fcpage/EngPrg3/Datasheets/Stepper Motor/Pololu - A4988 Module Setup_files/0J10063.1200.jpg

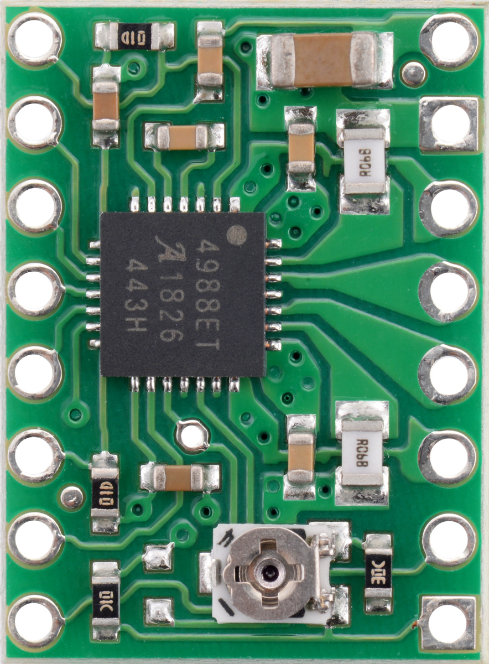
Datasheets/Stepper Motor/Pololu - A4988 Module Setup_files/0J10063.1200.jpg
