fcpage/EngPrg3/Datasheets/Stepper Motor/Pololu - A4988 Module Schematic_files/0J10062.1200.jpg

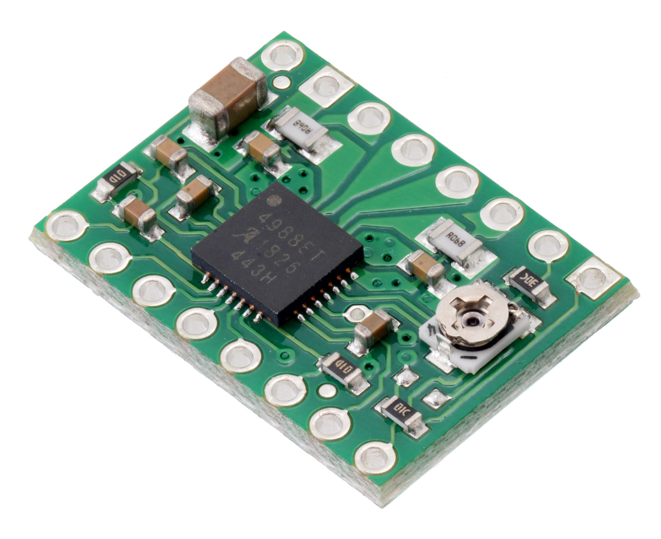
Datasheets/Stepper Motor/Pololu - A4988 Module Schematic_files/0J10062.1200.jpg
