fcpage/EngPrg3/Datasheets/RPI5/RPI Documentation Link.txt

https://www.raspberrypi.com/documentation/
