fcpage/EngPrg3/Presentation/ESE Engineering Project V.pptx

## ESE Engineering Project V Project 3: Etch Auto Sketch

Fergus Page
December 4th, 2025

## Project Overview:

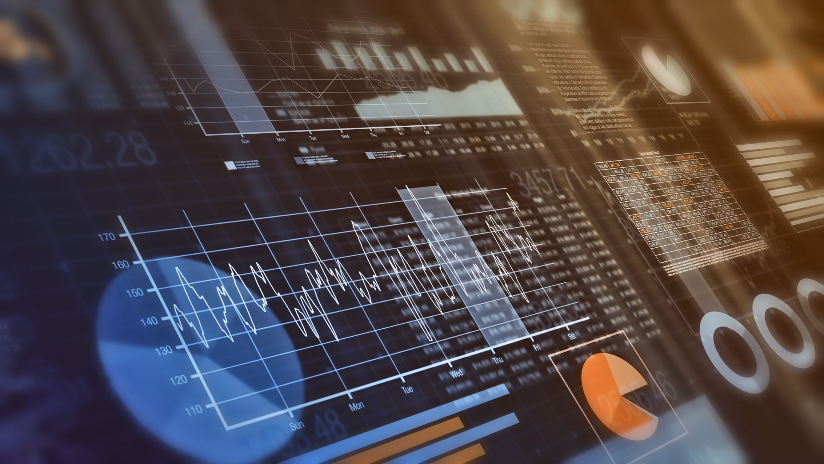
[picture p3: figure]
Digital financial graph

Posture-recognition software evaluates user.
Posture encoded as controller commands.
Software communicates wirelessly with controller.
Controller articulates Etch A Sketch.
PI-Controlled DC, stepper motors.

## Extended Applications

Remote, multi-pilot medical robots.
Exactly-repeated experimental research iterations.
Proxy agent for dangerous work.
A whimsical home message board.
User-scaling APPLICATIONS & COMBINATIONAL CONTROL.

## United Nations Sustainable Development Goals

Goal 3: Good Health and Wellbeing.
Goal 4: Quality Education.
Goal 9: Industry, Innovation, and Infrastructure.
Goal 10: Reduced Inequalities.
Goal 17: Partnerships for the Goals.

## System Overview

RPi 5 and STM32F303RE
Webcam, NRF24L01+, SSD1306, TL082, TL084
L293D and A4899
FIT0185 and 17HS4401S
Etch A Sketch – Large, Red

## Software and Control Considerations

Raspbian Linux video capture/DSP.
RPi 5 and controller communicate bidirectionally.
C-coded finite state machine.
PI-controlled DC motor.
Controller features tunable physical alignment.

## RF, Safety, and Compliance Considerations

RF-Compliant Transceiver Module (EU)
IEC 62368-1 Compliant Power Supply (+)
Additional Copper Ground Buss (Supply)
Cable Routing by Signal Speed
Cable Routing by Power

## Top Level System Diagram

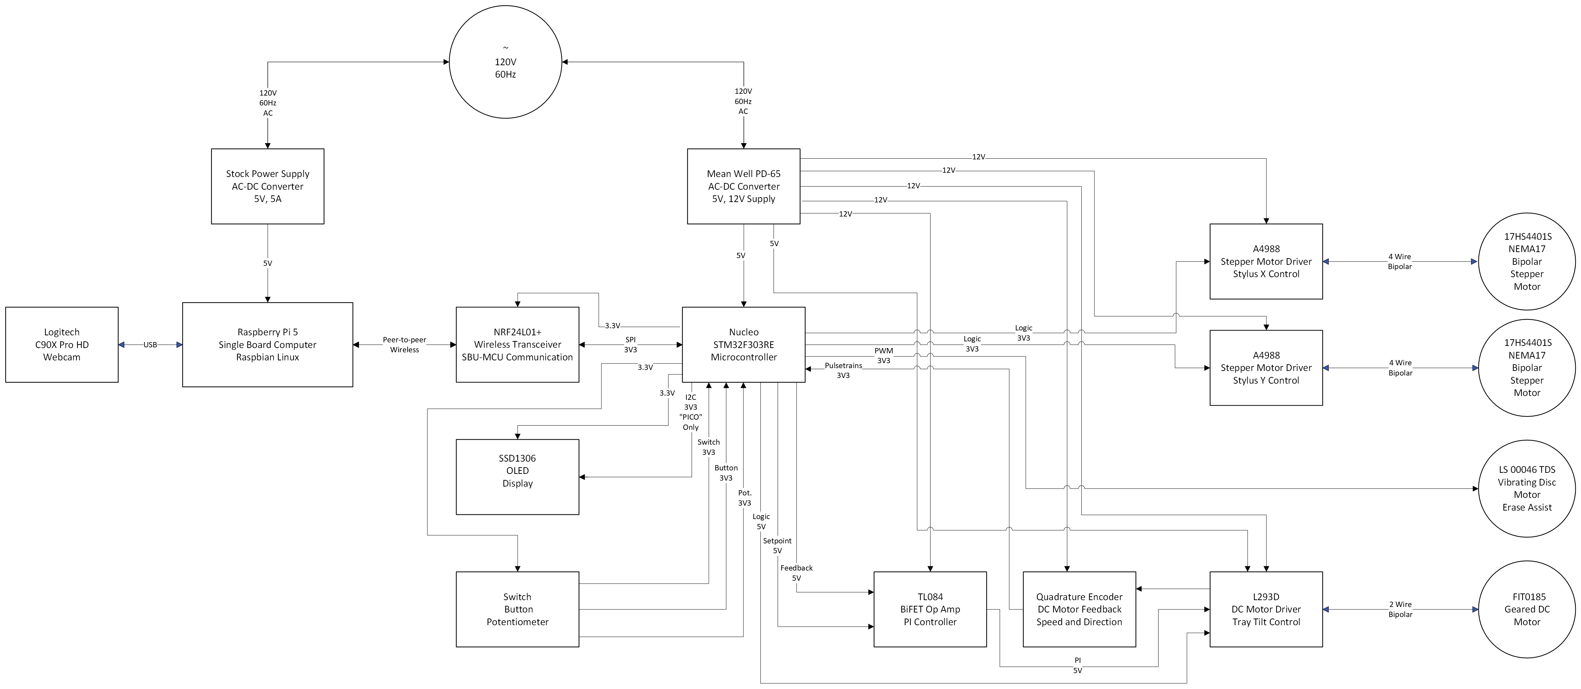
[picture p4: figure]

## System Prototype

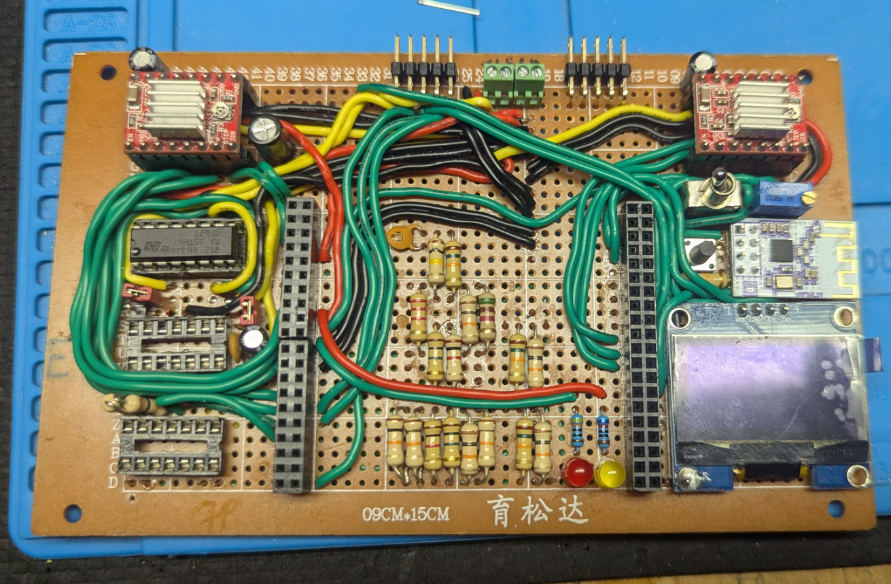
[picture p5: figure]
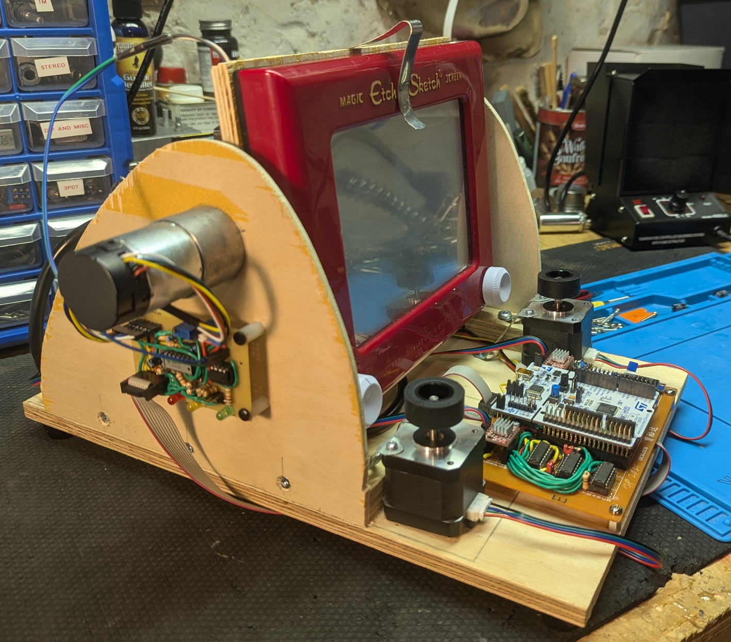
[picture p6: figure]
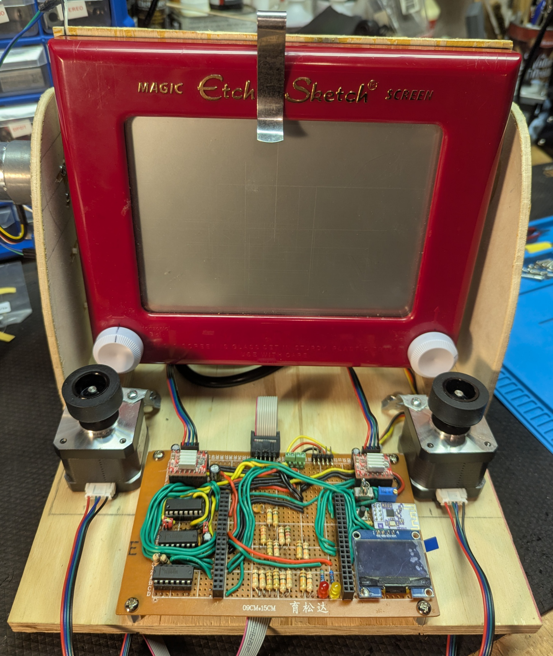
[picture p7: figure]
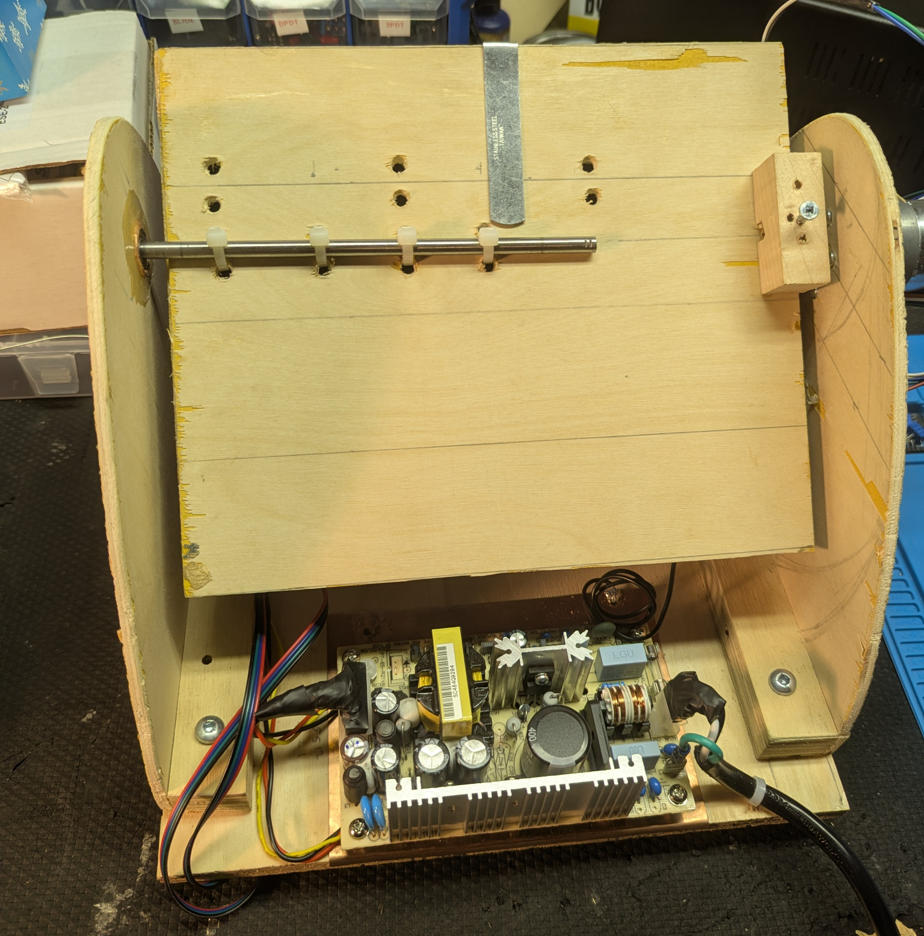
[picture p8: figure]

## DC Motor Characterization

FIT0185 High-Torque Geared Motor
Moment of Inertia Not Available
Calculated Approximate Value Using Datasheet
Motor Torque Exceeds Meter Limit

## Motor Characterization Calculations

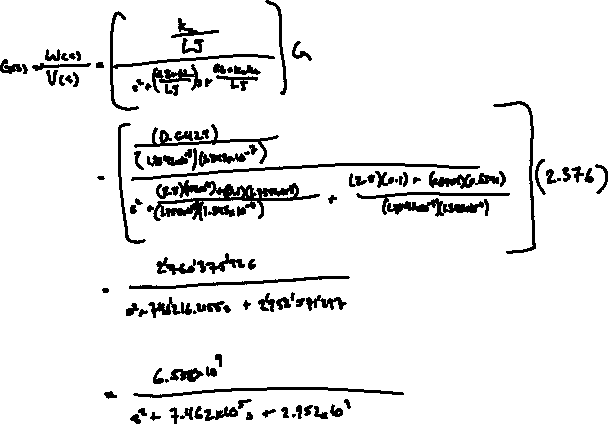
[picture p9: figure]
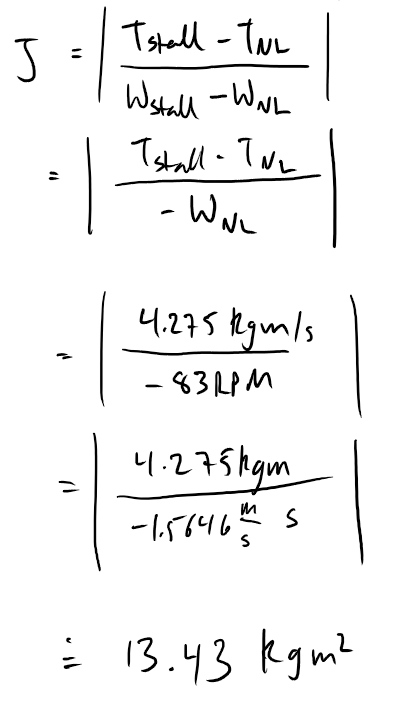
[picture p10: figure]
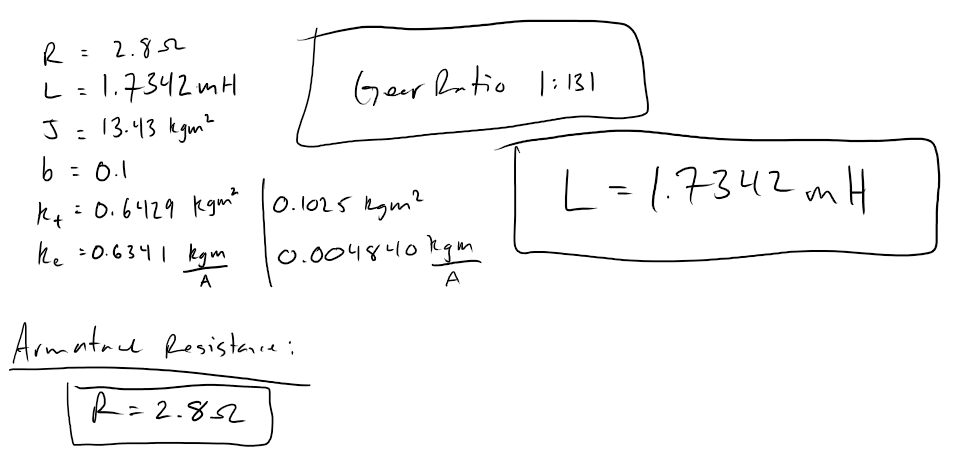
[picture p11: figure]
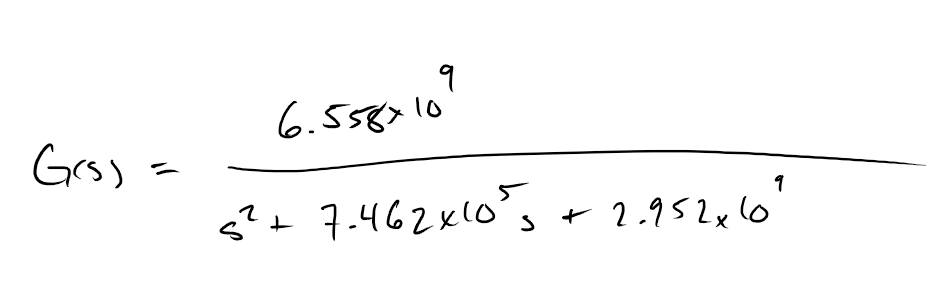
[picture p12: figure]

## Step Responses

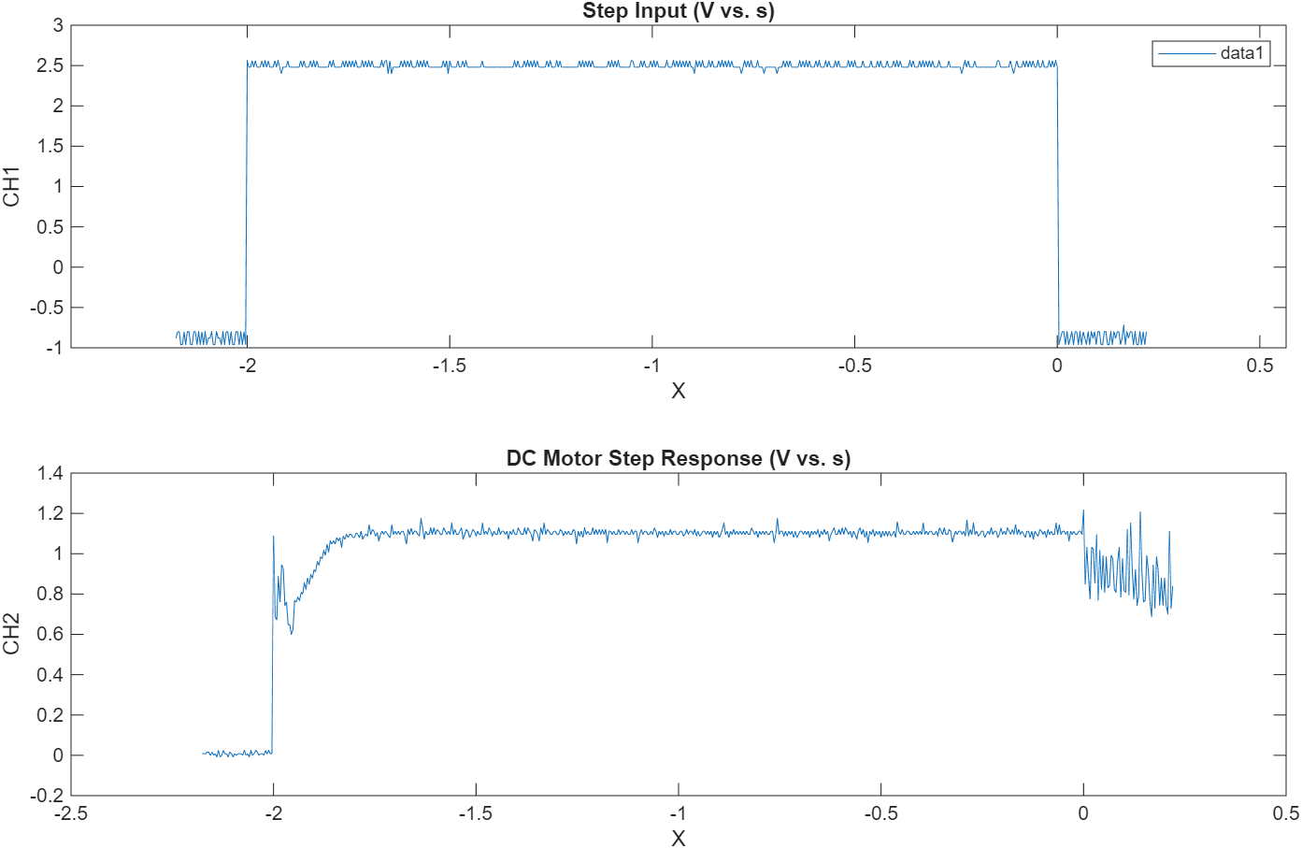
[picture p13: figure]
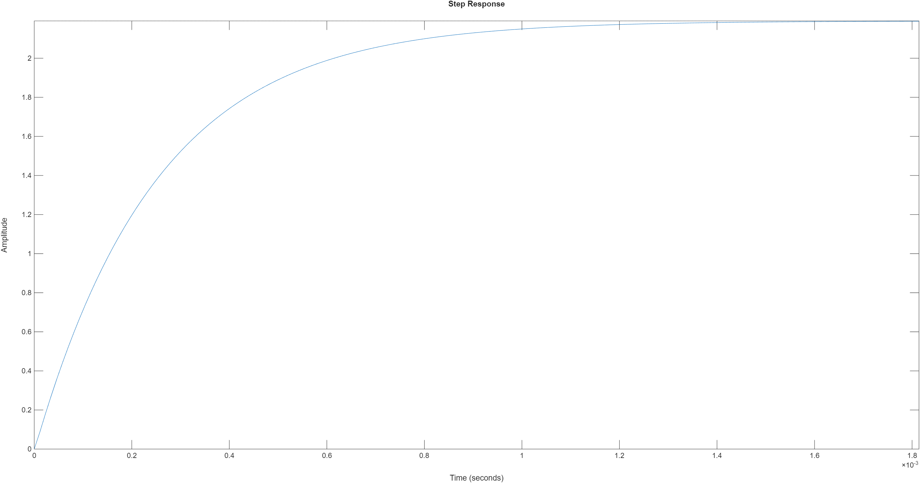
[picture p14: figure]

## PI Controller Calculations

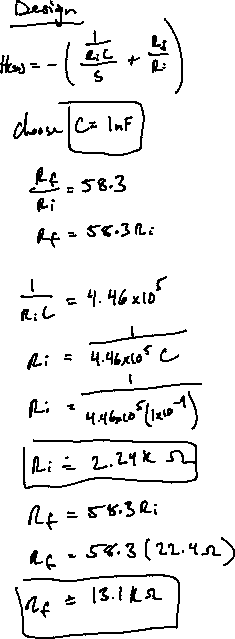
[picture p15: figure]
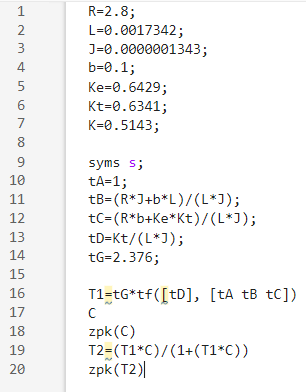
[picture p16: figure]
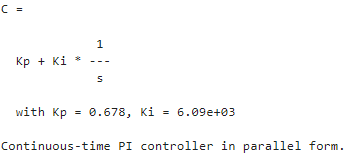
[picture p17: figure]
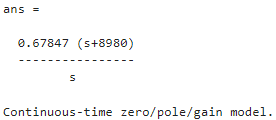
[picture p18: figure]

## PI Controller

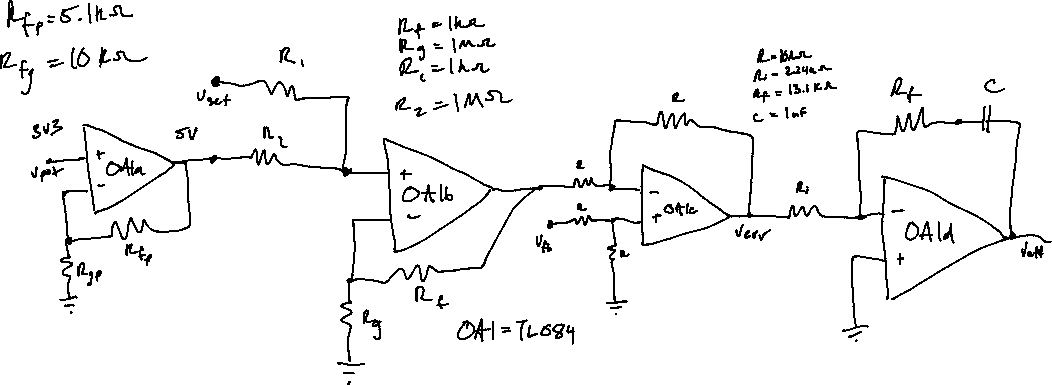
[picture p19: figure]

## DC Motor - Erase

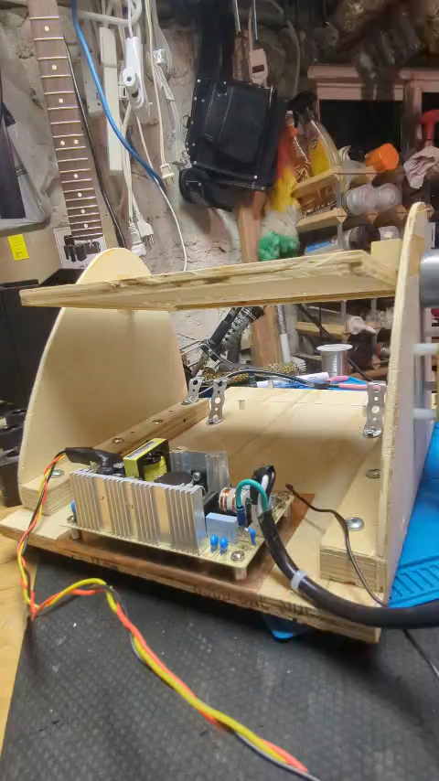
[picture p20: figure]

## Code Highlights

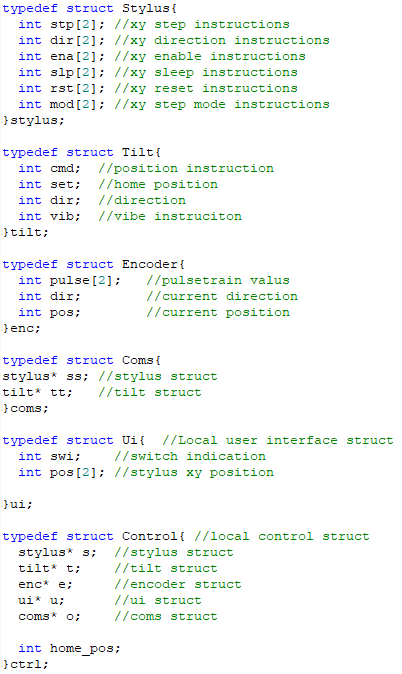
[picture p21: figure]
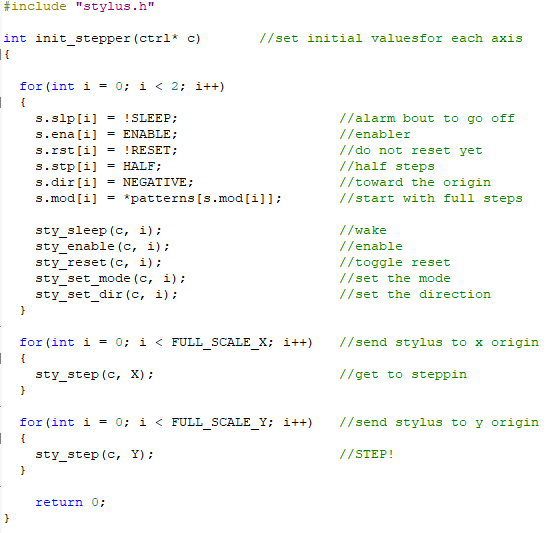
[picture p22: figure]

## Techniques, Resources, and Tools

Torque, Torsion, Tolerance, and Alignment
STM32, RPI5, Signal Generator, Oscilloscope
Quadrature Encoder, STM Encoder Mode
MATLAB PI Design, Electronic Implementation
MATLAB Oscilloscope Plotter Script

## Materials, Components, Sustainability & Circularity Design

Scrap Plywood: an Engineered Material
Low-Friction Bearing Reduces Load
Soft Rubber Rollers Grip Controls
Enables Aggressive Conservancy Measures, Safely
Remote-Physical Connection Reduces Waste

## Health, Social, Environmental Proactive Views

- Improves Rural & Remote Medical Access
- Protects Humans Doing Dangerous Work
- Enhances and Modernizes Scientific Research
- Enables New Controls and Applications
- Connects People and Humanoids Everywhere

## Acknowledgements

- Thank you to So-Ra Chung and Alireza Dehghani-Sanij for their help and guidance throughout this term, and with this project.
- I am very grateful, and I feel lucky to learn from them.

## References

Application Report: Designing Gain and Offset in Thirty Seconds, vol. SLOA097. Dallas: Texas Instruments, 2002.
