fcpage/EngPrg3/Datasheets/Stepper Motor/Pololu - A4988 Module Schematic_files/0J3359.600x480.jpg

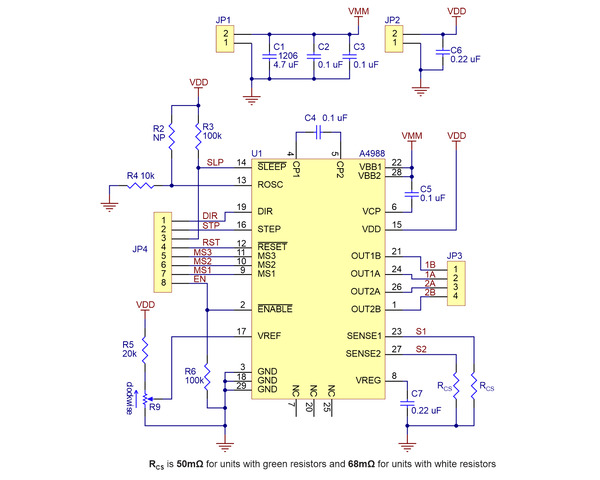
Datasheets/Stepper Motor/Pololu - A4988 Module Schematic_files/0J3359.600x480.jpg
