fcpage/EngPrg3/Photos/DCM Simulated/Motor Sim.png

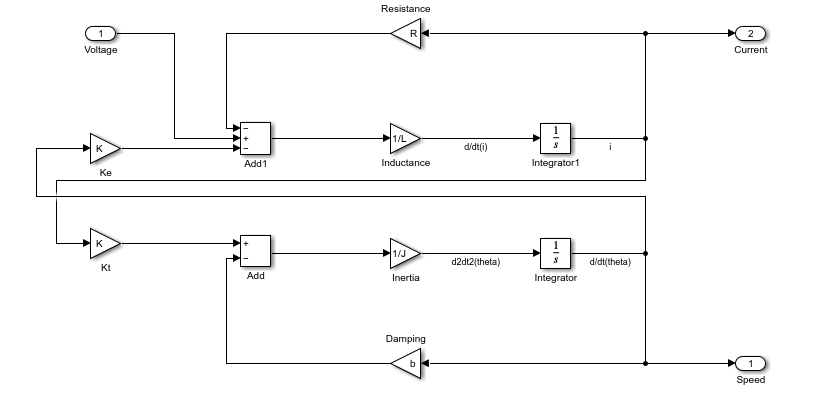
Photos/DCM Simulated/Motor Sim.png
