fcpage/EngPrg3/Photos/DCM Simulated/TRANSFER FUNCTION.png

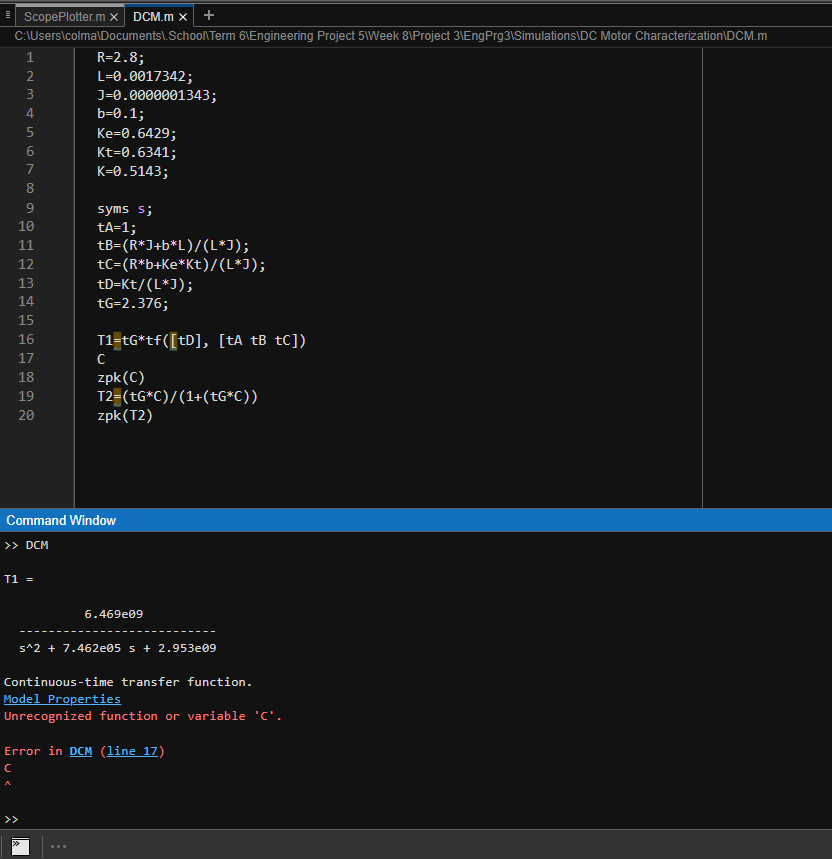
Photos/DCM Simulated/TRANSFER FUNCTION.png
