fcpage/EngPrg3/Photos/DCM Simulated/TUNED PI CONTROLLER.png

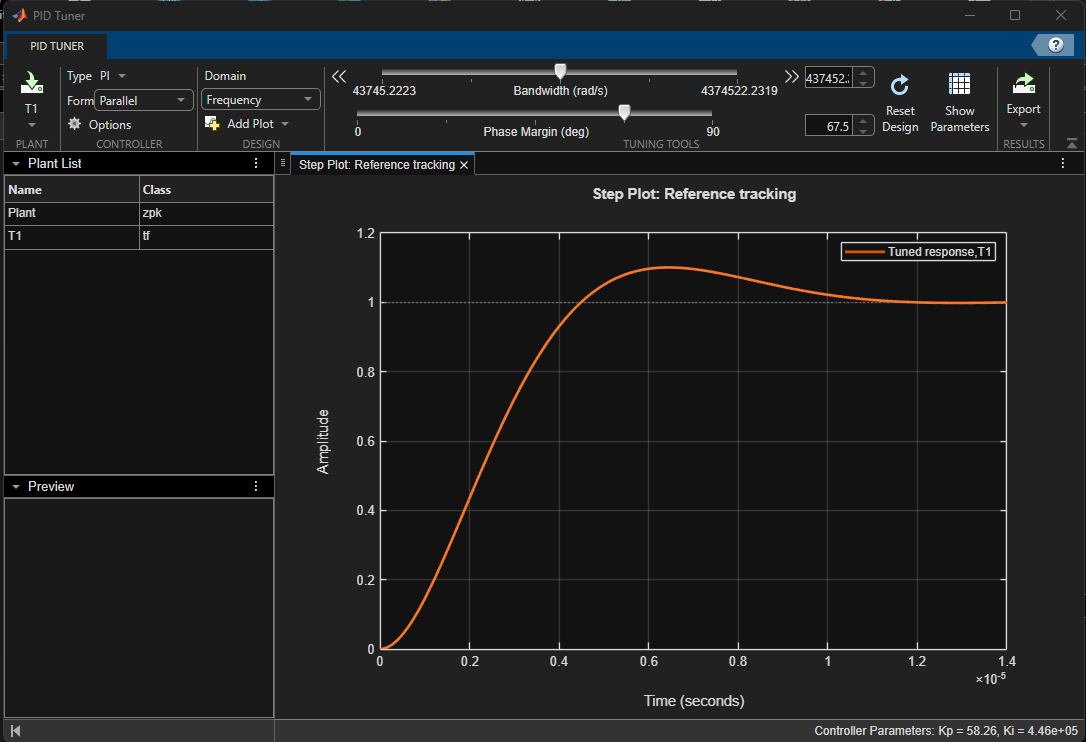
Photos/DCM Simulated/TUNED PI CONTROLLER.png
