fcpage/EngPrg3/Plans/Master Sheet.xlsx

Sheet: BOM
Description | Model | Manufacturer | Purchase Quantity | Project Quantity | Purchase Price | Price Each | Project Price | Total Price | Total Price Minus Brains
Linux SBC | RPI 5 | Raspberry Pi | 1 | 1 | $282.38 | $282.38 | $282.38 | $402.86 | $103.03
ARM Microcontroller | STM32F303RE | ST Microelectronics | 1 | 1 | $17.45 | $17.45 | $17.45
Quad Op Amp | TL084 | Texas Instruments | 1 | 1 | $3.33 | $3.33 | $3.33
Stepper Motor Driver | A4988 | Pololu/Allegro | 10 | 2 | $24.74 | $2.47 | $4.95
Stepper Motor | 17HS4401S | Handson Technology | 2 | 2 | $20.33 | $10.16 | $20.33
DC Motor Driver | L293D | Texas Instruments | 1 | 1 | $10.11 | $10.11 | $10.11
DC Motor | FIT0185 | DF Robot | 1 | 1 | $26.08 | $26.08 | $26.08
Vibrating Disc Motor | LS00046 | OSEPP | 2 | 1 | $8.98 | $4.49 | $4.49
LDO DC Regulator | LM2941C | Texas Instruments | 1 | 1 | $6.72 | $6.72 | $6.72
AC-DC Converter | PD-65A | Mean Well | 1 | 1 | $27.02 | $27.02 | $27.02

Sheet: Power Budget
Supply |  |  |  | Balance |  | Draw
Device |  |  |  | 5V Power Available | 12V Powet Available | Device | Rated Voltage (V) | Max Voltage (V) | Min Voltage (V) | Logic Voltage (V) | Motor Supply Voltage (V) | Chip Supply Voltage (V) | Logic Current (A) | Motor Current (A) | Target Current (A) | Rated Current (A) | Max Current (A) | Min Current (A) | Rated Power (W) | Max Power (W) | Min Power (W) | Extended Power Cost (W) | Total Power (W) | 5V Power | 12V Power
Mean Well PD-65A |  |  |  | 27.5 | 33.6 | RPI 5 | 5 | 5 | 5 | 3.3 | 0 | 0 |  | 0 | 0 | 5 | 5 | 5 | 25 | 25 | 25 | 25 | 46.5485 | 27.773 | 18.708
Parameter | Output A | Output B | Total | 5V Power Draw | 12V Power Draw | STM32 (E5V) | 5 | 5.25 | 4.75 | 3.3 | 0 | 3.6 |  | 0 | 0 | 0.5 | 0.5 | 0.1 | 2.5 | 2.625 | 0.475 | 2.5
Rated Voltage (V) | 5 | 12 |  | 27.773 | 18.708 | TL084 | 12 | 30 | 10 | 3.3 | 0 | 0 | 0.004 | 0 | 0.004 | 0.044 | 0.044 | 0.004 | 0.528 | 1.32 | 0.04 | 0.528
Rated Current (A) | 5.5 | 2.8 | 8.3 | 5V Power Balance | 12V Powet Balance | A4988 | 5 | 5.5 | 0.3 | 5 | 12 | 5 | 0.008 | 0 | 0.006 | 0.008 | 0.008 | 0.004 | 0.072 | 0.044 | 0.0012 | 0.088
Max Current (A) | 7 | 3.2 | 10.2 | -0.273 | 14.892 | 17HS4401S | 12 | 12 | 0 | 0 | 12 | 0 | 0 | 0.5 | 0.5 | 1.5 | 1.7 | 0.002 | 6 | 20.4 | 0 | 12
Min Current (A) | 0.4 | 0.2 | 0.6 | 5V Current Available | 12V Current Available | L293D | 7 | 7 | 4.5 | 5 | 0 | 5 | 0.041 | 0 | 0.041 | 0.037 | 0.066 | 0.021 | 0.185 | 0.462 | 0.0945 | 0.185
Rated Power (W) | 27.5 | 33.6 | 61.1 | 5.5 | 2.8 | FIT0185 | 12 | 12 | 0 | 0 | 12 | 0 | 0 | 0.5 | 0.5 | 0.5 | 7 | 0 | 6 | 84 | 0 | 6
Max Power (W) | 35 | 38.4 | 73.4 | 5V Current Draw | 12V Current Draw | LS00046 | 3.3 | 4.2 | 2.3 | 3.3 | 0 | 0 | 0 | 0 | 0.075 | 0.075 | 0.095 | 0 | 0.2475 | 0.399 | 0 | 0.2475
Min Power (W) | 2 | 2.4 | 4.4 | 5.5546 | 1.559 | LM2941C | 12 | 45 | 5.5 | 0 | 0 | 12 | 0 | 0 | 0.015 | 0.015 | 0.015 | 0.01 | 0.18 | 0.675 | 0.055 | 0.18
 |  |  |  | 5V Current Balance | 12V Current Balance
Device |  |  |  | -0.0546 | 1.241
LM2941C |  |  |  | 5V Current Supp. | 12V Current Comp.
Parameter | Output |  |  | 0.101 | -0.116
Rated Voltage (V) | 45 |  |  | 5V Current Result | 12V Current Result
Rated Current (A) | 1 |  |  | 0.0464 | 1.125
Max Current (A) | 1.6
Min Current (A) | 0
Rated Power (W) | 45
Max Power (W) | 72
Min Power (W) | 0
Note:
The stepper motors and DC motor will never operate at the same time, so the Current allotted to one type of motor becomes available as headroom for the other kind, when inactive.

Sheet: Voltage and Current Limitations
Part | Supply Level (V) | Logic Level (V) | Input Tolerance (V) | High Level (V) | Low Level (V)
RPI 5 | 5 | 3.3 | 3.3 | 3.3 | 0
STM32F303RE | 5 | 3.3 | 3.3 | 3.3 | 0
TL084 | 12 | - | - | 12 | -
A4988 | 12 | 3.3-5 | 5.5 | 3.3-5 | 0
17HS4401S | 12 | - | 12 | 12 | 0
L293D | 12 | 5 | 7 | 5 | 0
FIT0185 | 12 | - | 12 | 12 | 0
LS00046 | 3.3 | 3.3 | 4.5 | 3.3 | 0
Encoder | 5 | 5 | 5 | 5 | 0

Sheet: STM Pinout
STM32F303RE
 |  |  |  | CN7 |  |  |  |  |  |  |  |  |  |  | CN10
Notes | Use | Assignment | Function | Pin | Pin | Function | Assignment | Use | Notes |  | Notes | Use | Assignment | Function | Pin | Pin | Function | Assignment | Use | Notes
 | STP_X | PC_10 | DIG_OUT | 1 | 38 |  | PC_11 |  |  |  |  |  | PC_9 |  | 1 | 38 | DIG_OUT | PC_8 | MO0_Y
 | DIR_X | PC_12 | DIG_OUT | 3 | 37 |  | PD_2 |  |  |  |  | OLED_CLK | PB_8 | I2C1_SCL | 3 | 37 | DIG_OUT | PC_6 | MO1_Y
 | 5V_IN | VDD | VDD | 5 | 36 | E5V | E5V | 5V_IN |  |  |  | OLED_DAT | PB_9 | I2C_SDA | 5 | 36 | DIG_OUT | PC_5 | MO2_Y
 | BOOT_BUT | BOOT0 | BOOT | 4 | 35 | GND | GND | GND |  |  |  | 5V_IN | AVDD | AVDD | 4 | 35 | 5V | 5V | 5V_OUT
 | N/C | N/C | N/C | 5 | 34 | N/C | N/C | N/C |  |  |  | GND | GND | GND | 5 | 34 | N/C | N/C | N/C
 | N/C | N/C | N/C | 6 | 33 | IOREF | IOREF | N/C |  |  |  | XCVR_CLK | PA_5 | SPI1_SCLK | 6 | 33 | DIG_OUT | PA_12 | SPI_CE
 | MO0_X | PA_13 | DIG_OUT | 7 | 32 | RESET | RESET | RST_BUT |  |  |  | XCVR_TX | PA_6 | SPI1_PICO | 7 | 32 | DIG_IN | PA_11 | SPI_IRQ
 | MO1_X | PA_14 | DIG_OUT | 8 | 31 | 3V3 | 3V3 | 3V3_OUT |  |  |  | XCVR_RX | PA_7 | SPI1_POCI | 8 | 31 | DIG_IN | PB_12 | LIM_F
 | MO2_X | PA_15 | DIG_OUT | 9 | 30 | 5V | 5V | 5V_OUT |  |  |  | SLP_Y | PB_6 | DIG_OUT | 9 | 30 | DIG_IN | PB_11 | LIM_R
 | GND | GND | GND | 10 | 29 | GND | GND | GND |  |  |  | RST_Y | PC_7 | DIG_OUT | 10 | 29 | GND | GND | GND
 |  | PB_7 |  | 11 | 28 | GND | GND | GND |  |  |  | EN_Y | PA_9 | DIG_OUT | 11 | 28 | AnalogIn | PB_2 | POT_U
 |  | PC_13 |  | 12 | 27 | VIN | VIN | N/C |  |  |  |  | PA_8 |  | 12 | 27 | DIG_IN | PB_1 | SW_U
 | SLP_X | PC_14 | DIG_OUT | 13 | 26 | N/C | N/C | N/C |  |  |  |  | PB_10 |  | 13 | 26 | DIG_IN | PB_15 | BUT_U
 | RST_X | PC_15 | DIG_OUT | 14 | 25 | DIG_IN | PA_0 | QEN_A | TIM2_CH1 |  |  |  | PB_4 |  | 14 | 25 | DIG_OUT | PB_14 | STP_Y
 | EN_X | PF_0 | DIG_OUT | 15 | 24 | DIG_IN | PA_1 | QEN_B | TIM2_CH2 |  |  |  | PB_5 |  | 15 | 24 | DIG_OUT | PB_13 | DIR_Y
 | DIR_DC | PF_1 | DIG_OUT | 16 | 23 |  | PA_4 |  |  |  |  |  | PB_3 |  | 16 | 23 | AGND | AGND | GND
 | N/C | VBAT | VBAT | 17 | 22 |  | PB_0 |  |  |  |  | SER1_RX | PA_10 | DIG_IN | 17 | 22 | DIG_OUT | PC_4 | SER1_TX
 | SET_DC | PC_2 | PWM1/3 | 18 | 21 | PWM1/2 | PC_1 | BUZ_U |  |  |  |  | PA_2 |  | 18 | 21 | N/C | N/C | N/C
 | FBK_DC | PC_3 | PWM1/4 | 19 | 20 | PWM1/1 | PC_0 | SET_VIB |  |  |  |  | PA_3 |  | 19 | 20 | N/C | N/C | N/C
 |  |  |  |  |  |  |  |  |  | 14 Free Pins

Sheet: L293D Pinout
L293D
Use | Assignment | Function | Pin | Pin | Function | Assignment | Use
PWM |  | 1,2 EN | 1 | 16 | V+ (Logic) | 5V | Logic Supply +
Direction |  | 1A | 2 | 15 | A3 |  | ~Direction
DCM A | DCM A | 1Y | 3 | 14 | Y3 | DCM B | DCM B
Supply - | GND | V- | 4 | 13 | V- | GND | Supply -
 |  |  | 5 | 12
DCM A | DCM A | Y2 | 6 | 11 | Y3 | DCM B | DCM B
Direction |  | A2 | 7 | 10 | A3 |  | ~Direction
Motor Supply + | 12V | V+ (Driver) | 8 | 9 | 3,4 EN |  | PWM

Sheet: A4988 Pinout
A4988
Use | Assignment | Function | Pin | Pin | Function | Assignment | Use
Standby |  | Enable | 1 | 16 | V+ (Driver) | 12V | Motor Supply +
Step Mode |  | Mode 1 | 2 | 15 | V- (Driver) | GND | Supply -
- | - | Mode 2 | 3 | 14 | Motor A |  | Coil A
- | - | Mode 3 | 4 | 13 | Motor ~A |  | Coil A
Reset |  | Reset | 5 | 12 | Motor B |  | Coil B
- | - | Sleep | 6 | 11 | Motor ~B |  | Coil B
PWM |  | Step | 7 | 10 | V+ (Logic) | 5V | Logic Supply +
Direction |  | Direction | 8 | 9 | V- (Logic) | GND | Supply -

Sheet: TL084 Pinout
TL084
Use | Assignment | Function | Pin | Pin | Function | Assignment | Use
 |  | O1 | 1 | 14 | O4
 |  | -1 | 2 | 13 | -4
 |  | +1 | 3 | 12 | +4
Supply - | 0V | V- | 4 | 11 | V+ | +12V | Supply +
 |  | +2 | 5 | 10 | +3
 |  | -2 | 6 | 9 | -3
 |  | O2 | 7 | 8 | O3
