fcpage/EngPrg3/Photos/DCM Measured/Output/DCM Driven Full Period Step.png

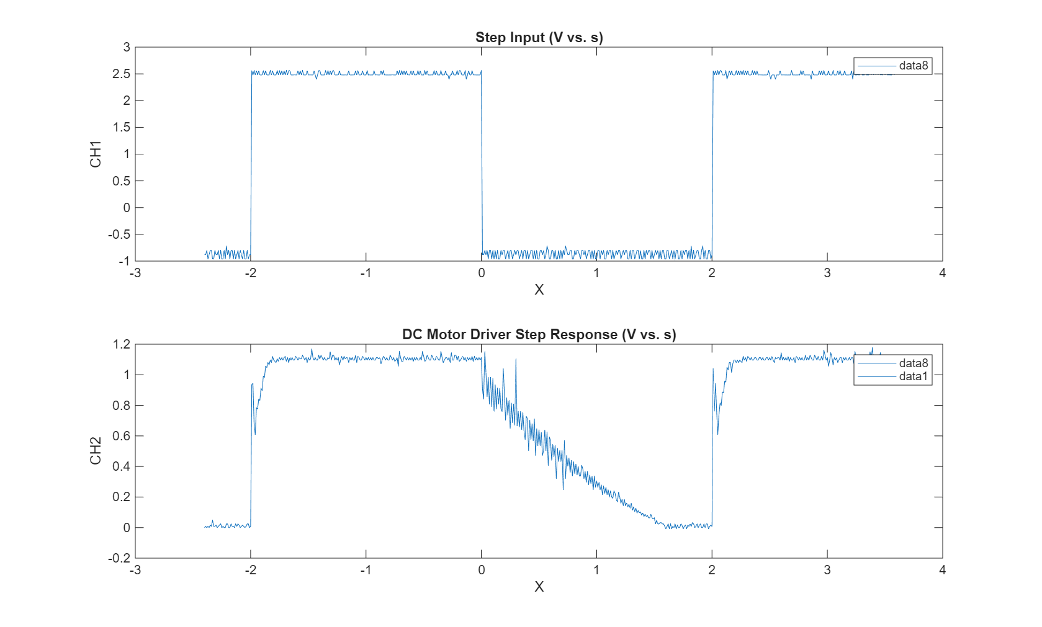
Photos/DCM Measured/Output/DCM Driven Full Period Step.png
