fcpage/EngPrg3/Photos/DCM Measured/Output/DCM Driver Step.png

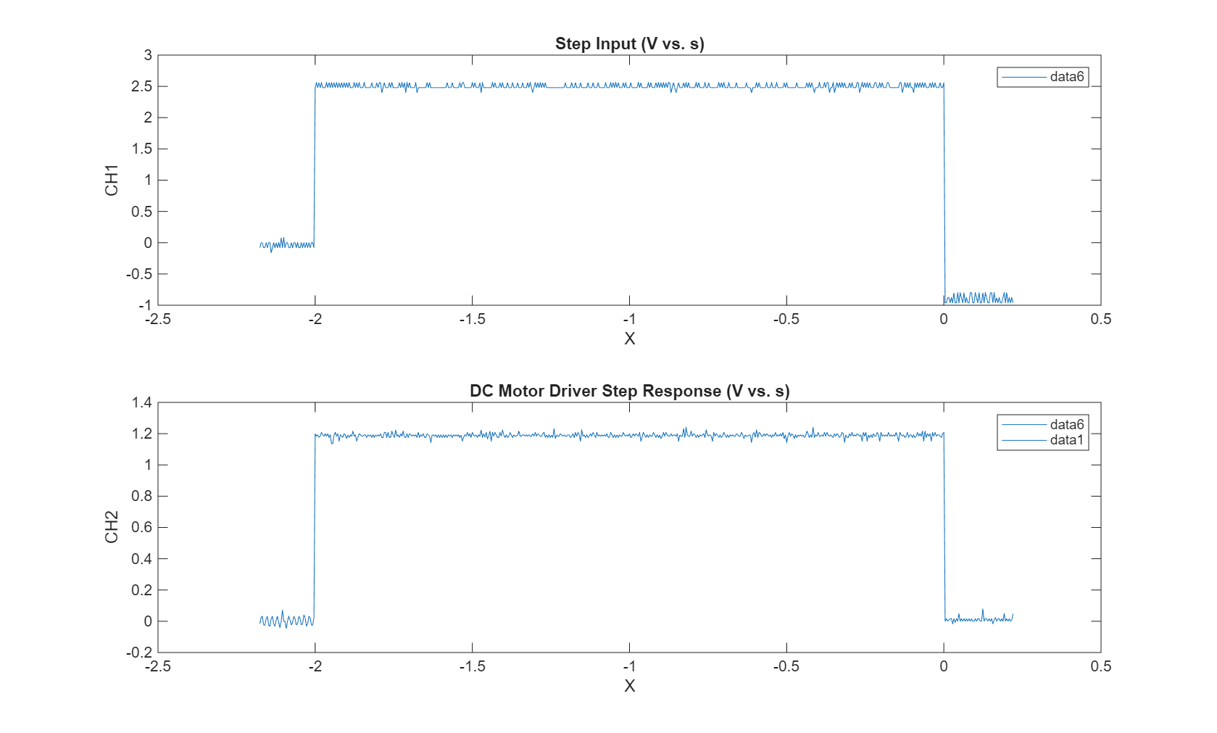
Photos/DCM Measured/Output/DCM Driver Step.png
