fcpage/EngPrg3/Photos/DCM Measured/Output/DCM Raw Step.png

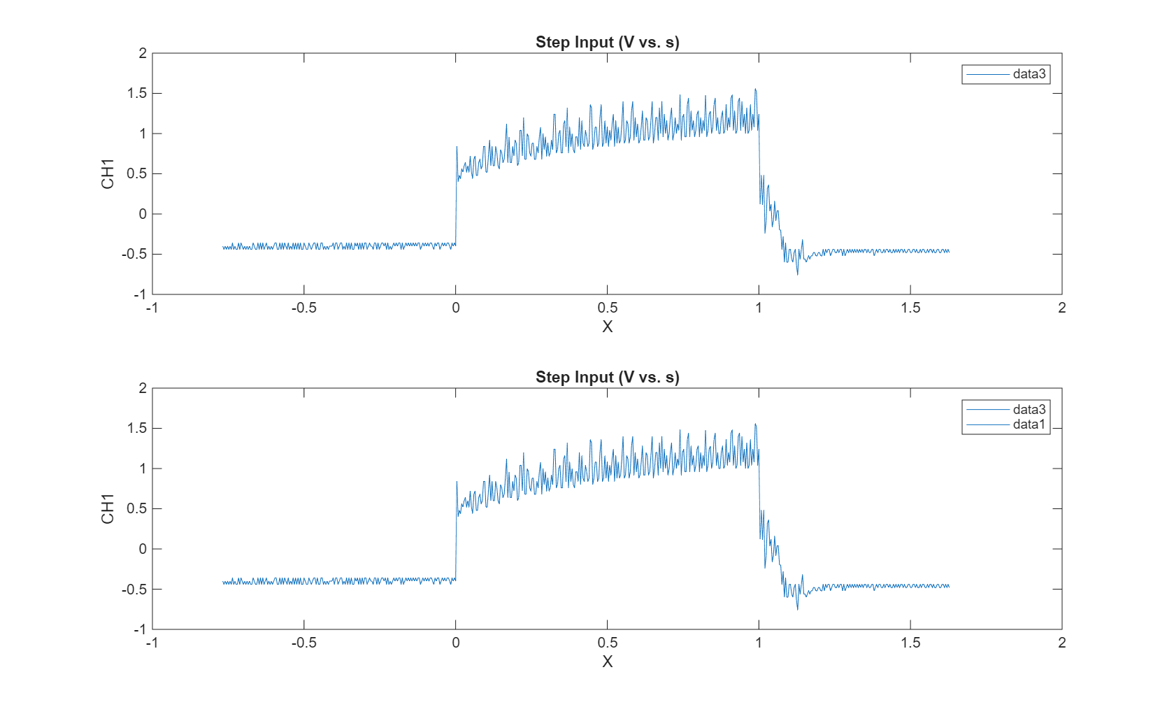
Photos/DCM Measured/Output/DCM Raw Step.png
