fcpage/EngPrg3/Photos/DCM Measured/Output/New Driven Step.png

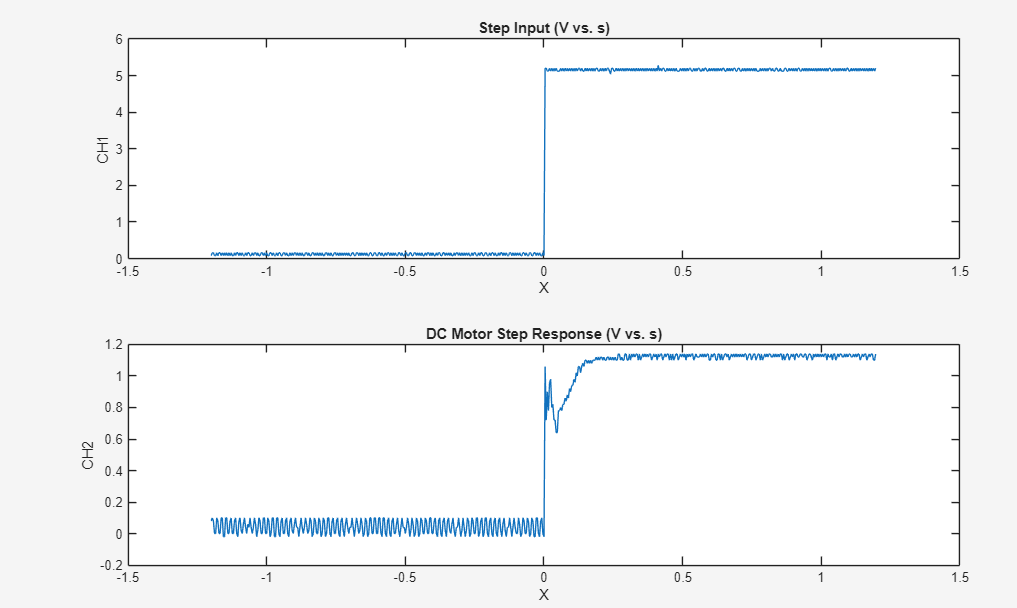
Photos/DCM Measured/Output/New Driven Step.png
