fcpage/EngPrg3/Photos/DCM Measured/Output/New Undriven Step.png

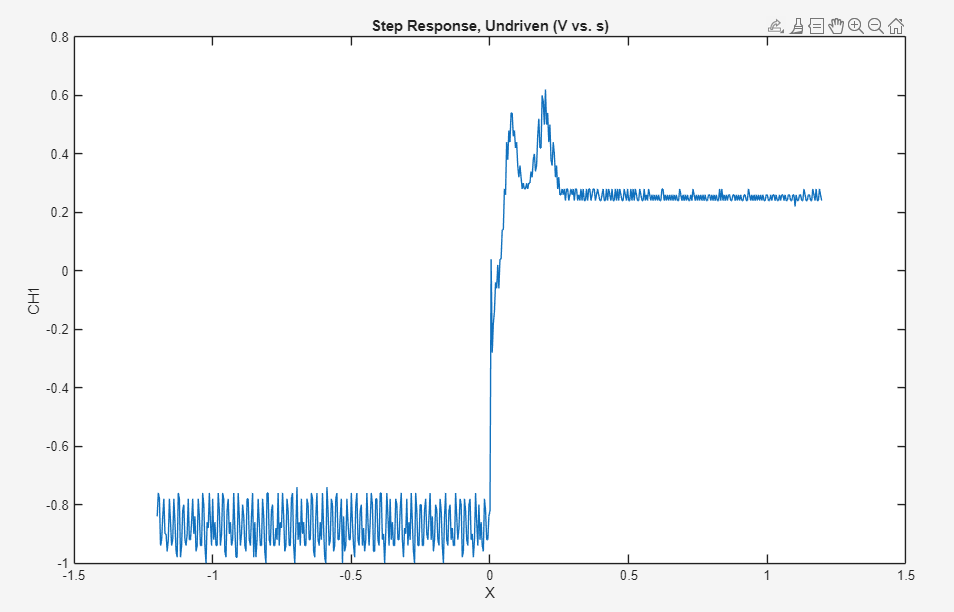
Photos/DCM Measured/Output/New Undriven Step.png
