fcpage/EngPrg3/Photos/DCM Simulated/DCM initial step - Sim.png

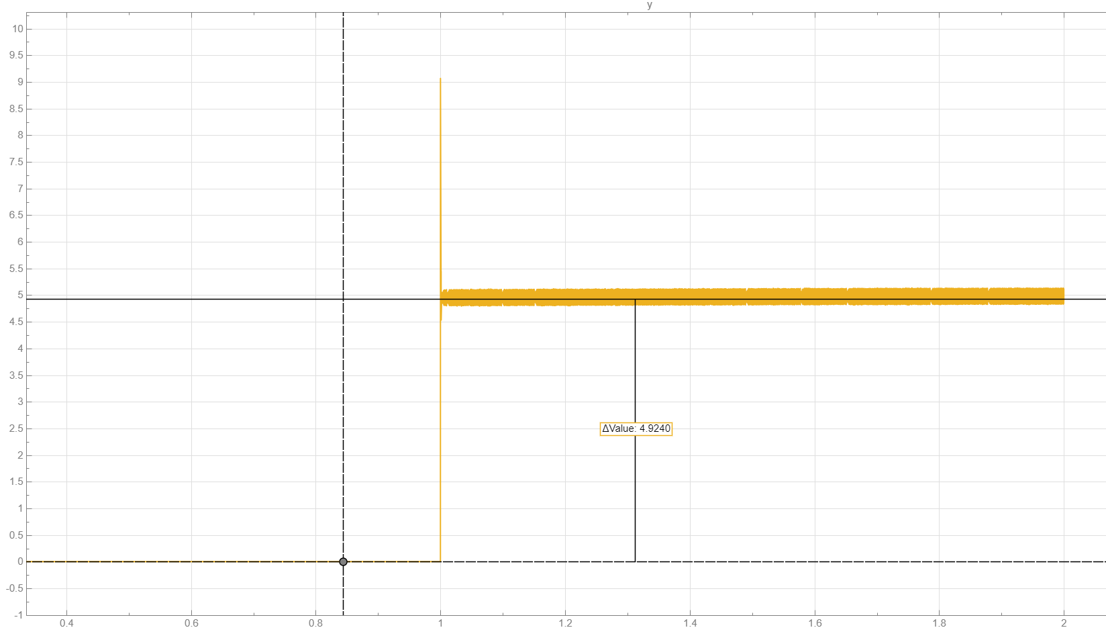
Photos/DCM Simulated/DCM initial step - Sim.png
