fcpage/EngPrg3/Photos/DCM Simulated/Final Sim Step Response.png

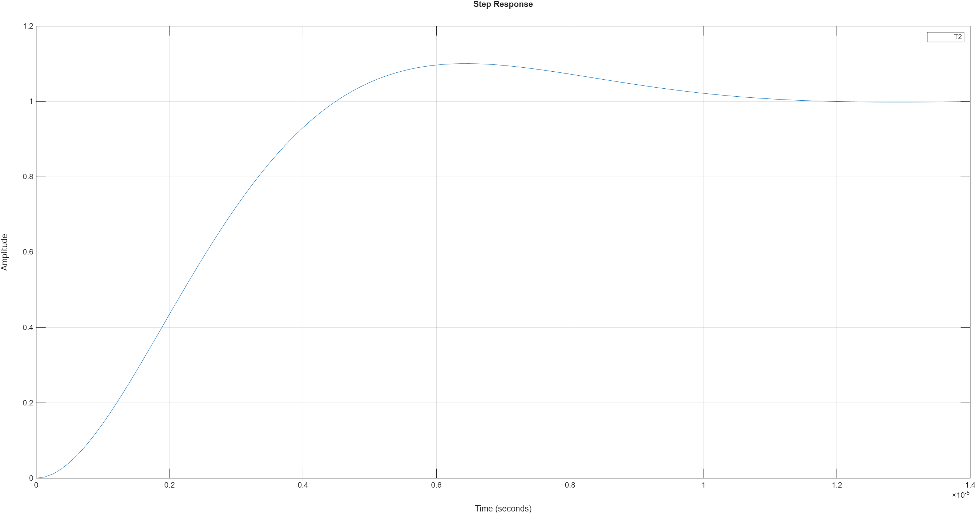
Photos/DCM Simulated/Final Sim Step Response.png
