fcpage/EngPrg3/Photos/DCM Simulated/Undriven Sim Step Response.png

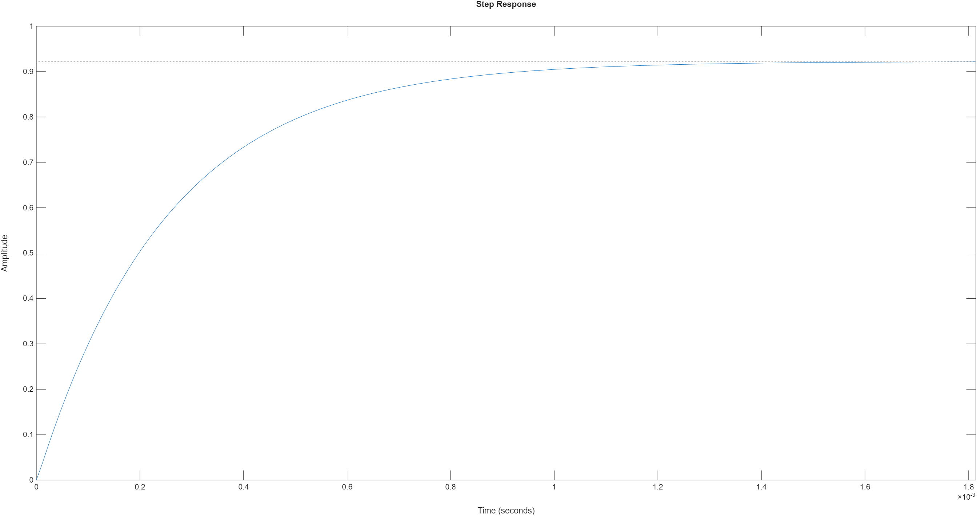
Photos/DCM Simulated/Undriven Sim Step Response.png
