fcpage/EngPrg3/Photos/DCM Measured/CSVs/DRIVEN_STE.csv

X | CH1 | CH2
Second | Volt | Volt
-2.4000001e+00 | -8.80000e-01 | 0.00000e+00
-2.3900001e+00 | -8.80000e-01 | 8.00000e-03
-2.3800001e+00 | -8.00000e-01 | 0.00000e+00
-2.3700001e+00 | -9.60000e-01 | 8.00000e-03
-2.3600001e+00 | -8.80000e-01 | 0.00000e+00
-2.3500001e+00 | -8.00000e-01 | 1.60000e-02
-2.3399999e+00 | -8.00000e-01 | 8.00000e-03
-2.3299999e+00 | -9.60000e-01 | 4.80000e-02
-2.3199999e+00 | -9.60000e-01 | 8.00000e-03
-2.3099999e+00 | -8.00000e-01 | 8.00000e-03
-2.3000000e+00 | -8.80000e-01 | 1.60000e-02
-2.2900000e+00 | -8.80000e-01 | 0.00000e+00
-2.2800000e+00 | -8.00000e-01 | 8.00000e-03
-2.2700000e+00 | -9.60000e-01 | 1.60000e-02
-2.2600000e+00 | -8.00000e-01 | 2.40000e-02
-2.2500000e+00 | -9.60000e-01 | 0.00000e+00
-2.2400000e+00 | -9.60000e-01 | 8.00000e-03
-2.2300000e+00 | -8.00000e-01 | 0.00000e+00
-2.2200000e+00 | -9.60000e-01 | 0.00000e+00
-2.2100000e+00 | -7.20000e-01 | 2.40000e-02
-2.2000000e+00 | -8.80000e-01 | 2.40000e-02
-2.1900001e+00 | -8.00000e-01 | 0.00000e+00
-2.1800001e+00 | -9.60000e-01 | 0.00000e+00
-2.1700001e+00 | -8.00000e-01 | 2.40000e-02
-2.1600001e+00 | -8.00000e-01 | 8.00000e-03
-2.1500001e+00 | -9.60000e-01 | 8.00000e-03
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
