fcpage/EngPrg3/Photos/DCM Measured/Output/DRIVEN_POS.png

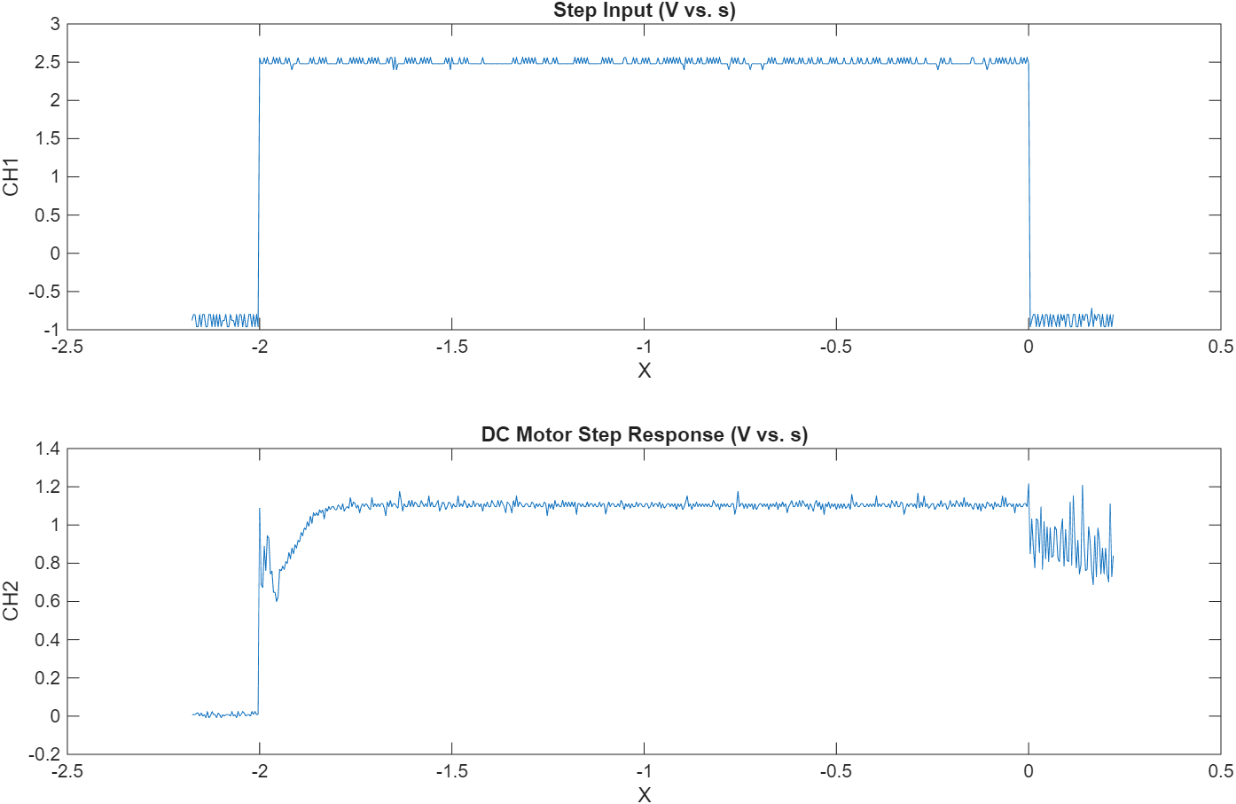
Photos/DCM Measured/Output/DRIVEN_POS.png
