fcpage/EngPrg3/Characterizations/Stepper Characterization - Proof of Concept.pdf

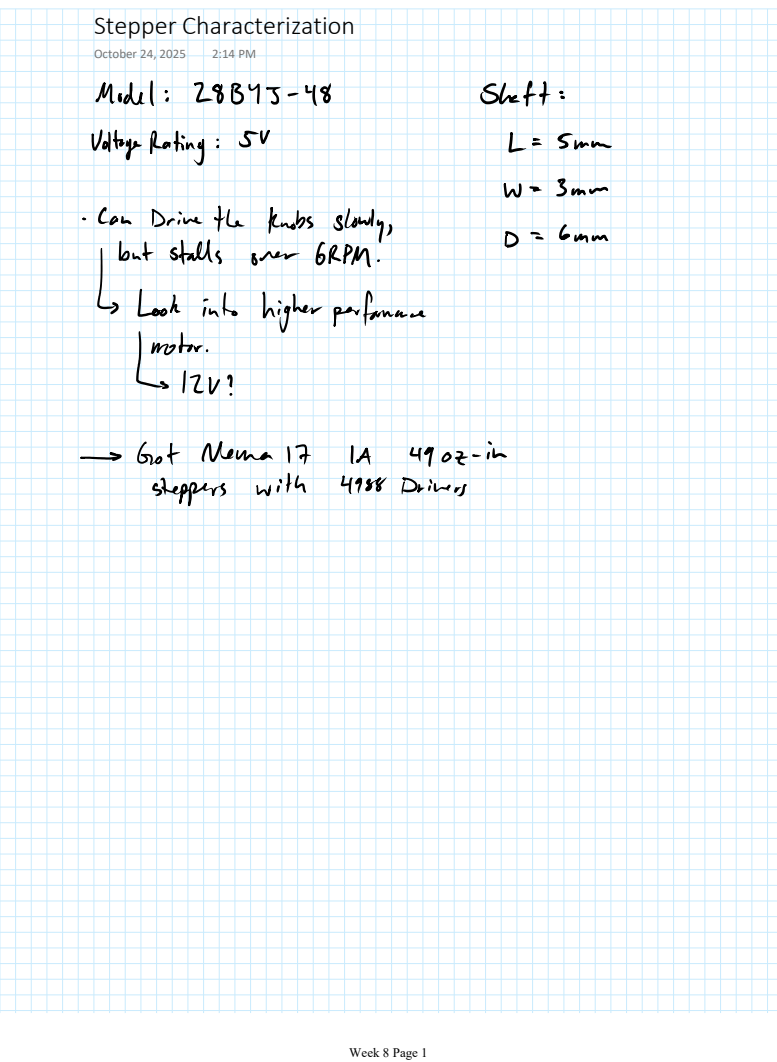
[picture p36: page 1]
Stepper Characterization; October 24, 2025; Week 8 Page 1
