fcpage/EngPrg3/Plans/Project 3 Driver.pdf

# Project 3 Driver

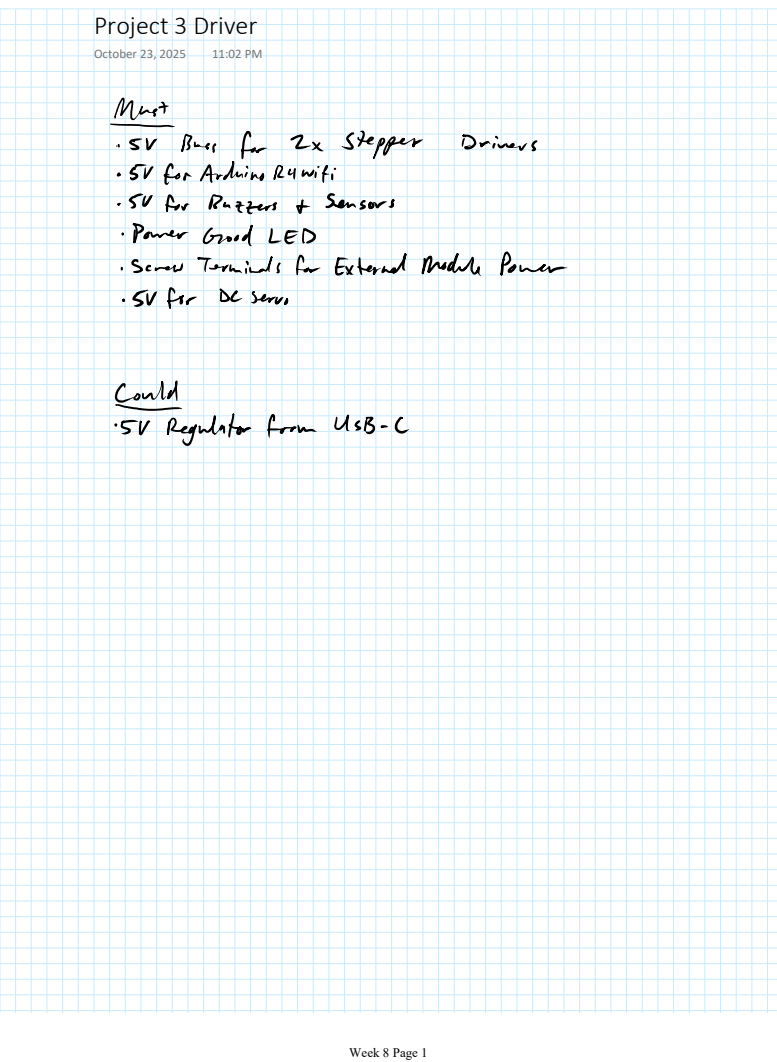
[picture p37: page 1]
October 23, 2025; Week 8 Page 1
