fcpage/EngPrg3/Characterizations/Etch A Sketch Characterization.pdf

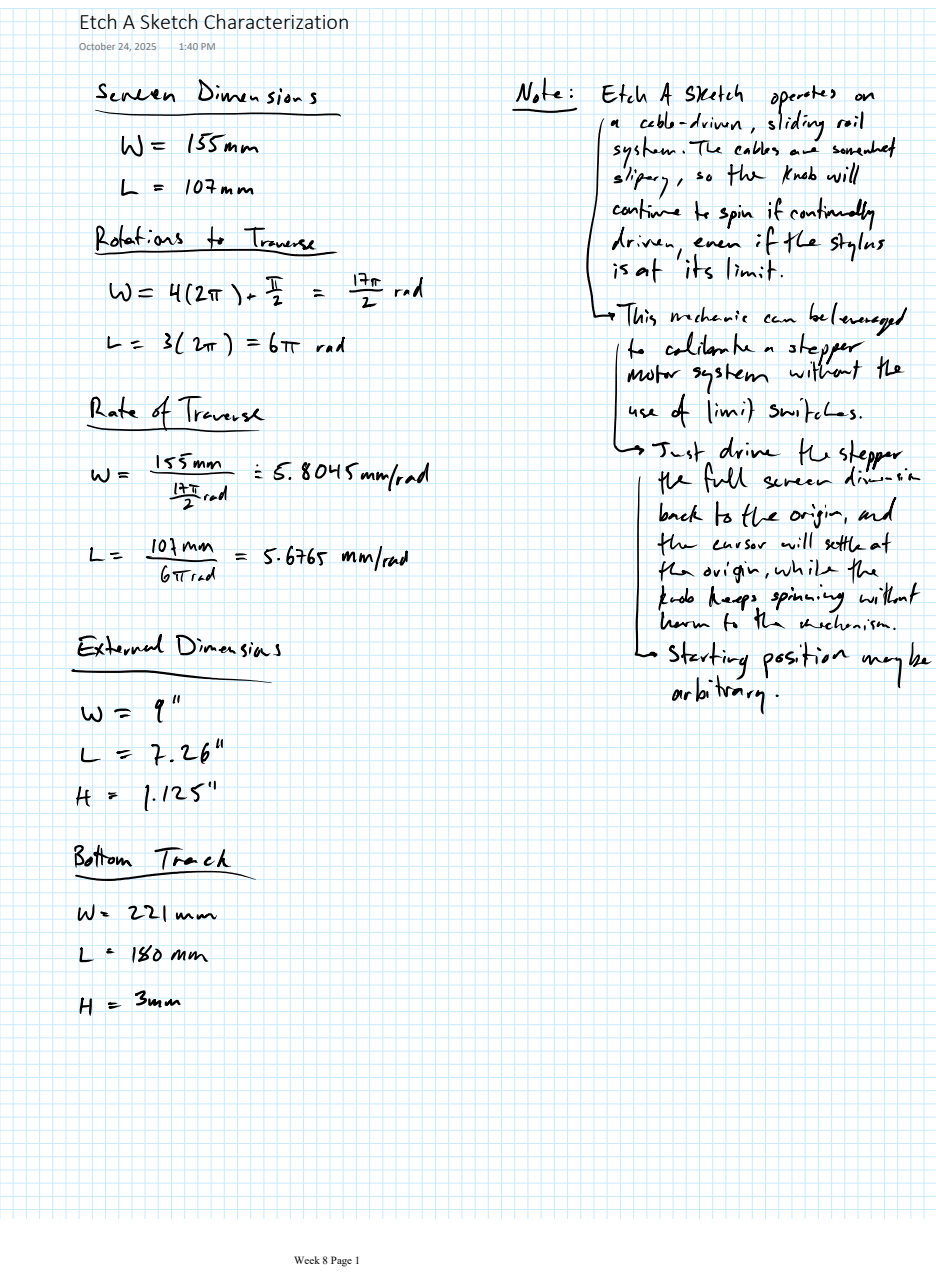
[picture p50: page 1]
October 24, 2025; Week 8 Page 1

Etch A Sketch Characterization
