fcpage/EngPrg3/Plans/Project 3 - Fixture.pdf

# Project 3 - Fixture

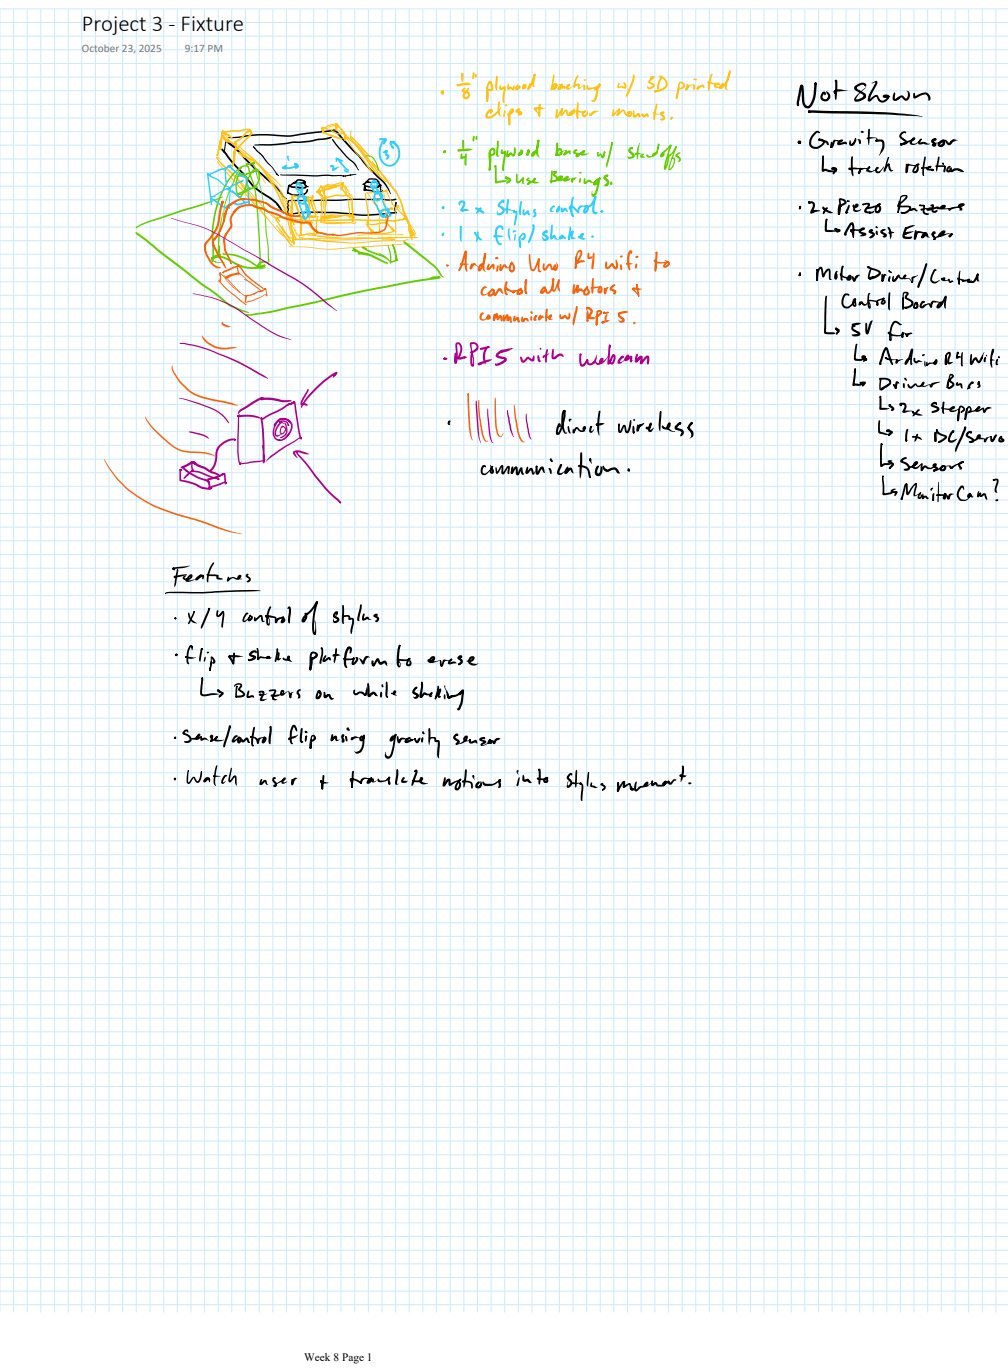
[picture p51: page 1]
October 23, 2025; Week 8 Page 1
