fcpage/EngPrg3/Schematics/AutoSketch/dcm.kicad_sch

## KiCad design Schematics/AutoSketch/dcm.kicad_sch (2025-11-06, an earlier design)

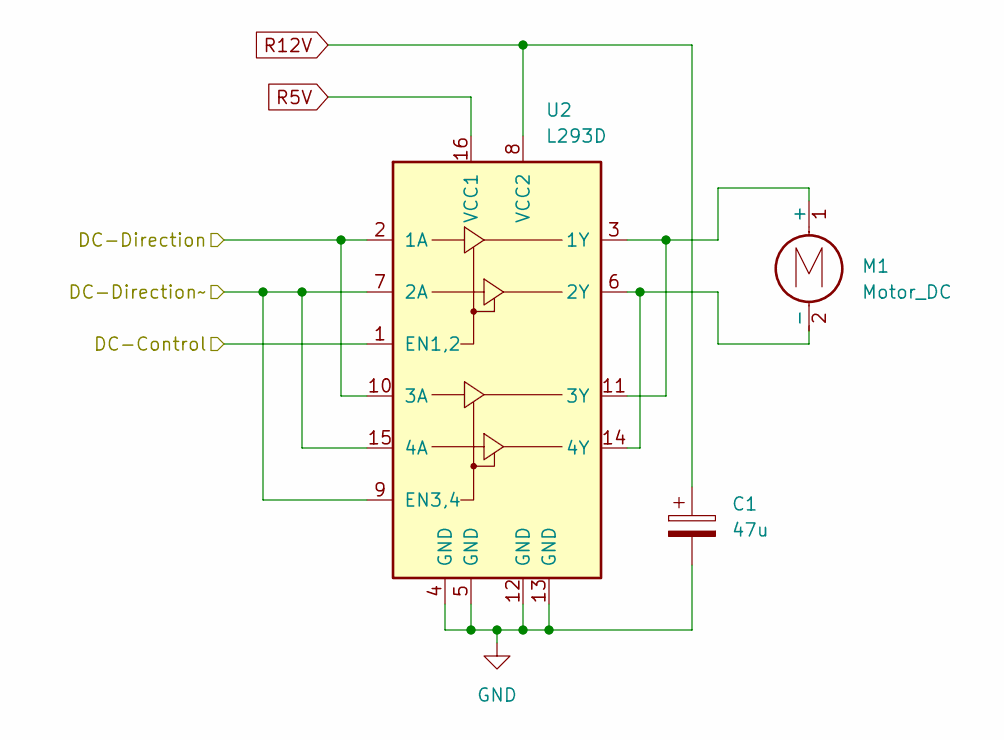
[picture p52: schematic dcm.kicad_sch]

Parts:
C1: 47u
M1: Motor_DC
U2: L293D; DIP-16_W7.62mm

Connections:
DC-Control: U2.1 (EN1,2)
DC-Direction: U2.2 (1A), U2.10 (3A)
DC-Direction~: U2.7 (2A), U2.9 (EN3,4), U2.15 (4A)
GND: C1.2, U2.4 (GND), U2.5 (GND), U2.12 (GND), U2.13 (GND)
unnamed: M1.1 (+), U2.3 (1Y), U2.11 (3Y)
unnamed: M1.2 (-), U2.6 (2Y), U2.14 (4Y)
R5V: U2.16 (VCC1)
R12V: C1.1, U2.8 (VCC2)
