fcpage/EngPrg3/Schematics/AutoSketch/encoder.kicad_sch

## KiCad design Schematics/AutoSketch/encoder.kicad_sch (2025-11-06, an earlier design)

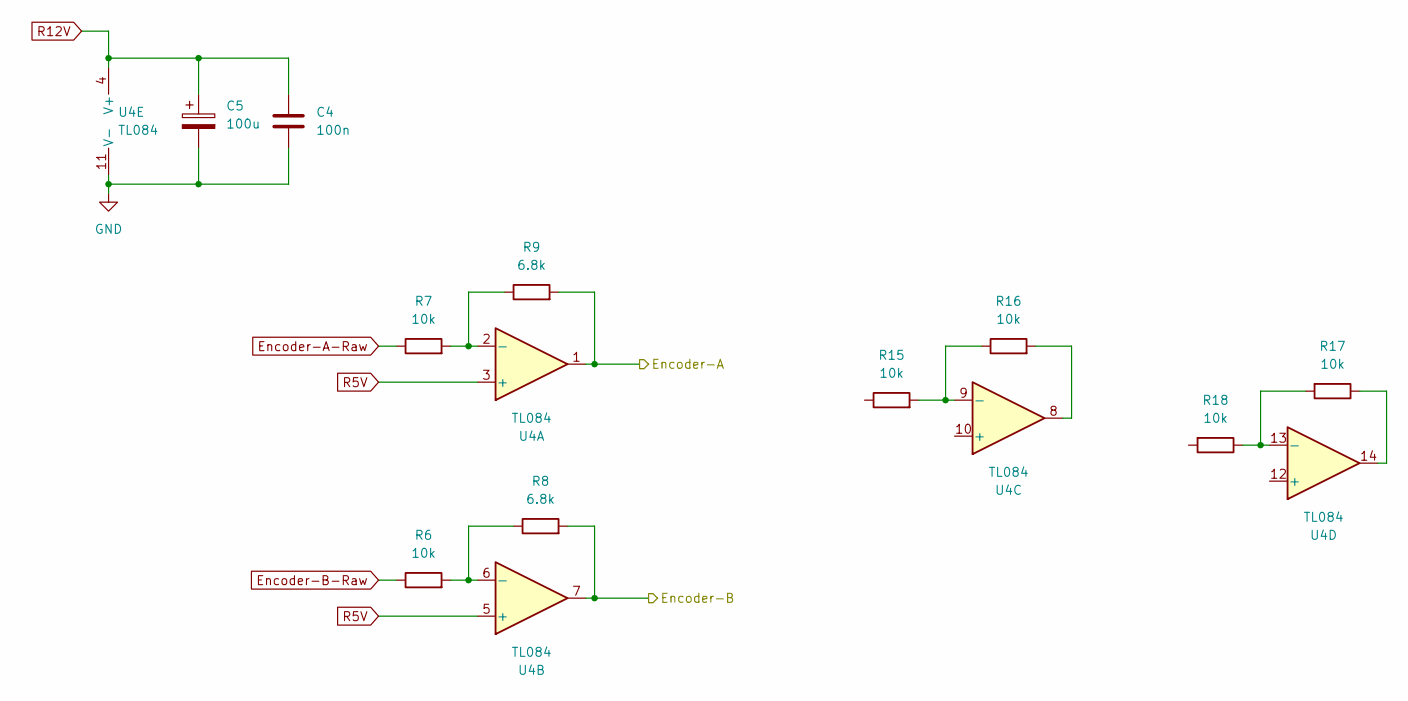
[picture p53: schematic encoder.kicad_sch]

Parts:
C4: 100n
C5: 100u
R6, R7, R15, R16, R17, R18: 10k
R8, R9: 6.8k
U4: TL084

Connections:
Encoder-A: R9.2, U4.1
Encoder-A-Raw: R7.1
Encoder-B: R8.2, U4.7
Encoder-B-Raw: R6.1
GND: C4.2, C5.2, U4.11 (V-)
unnamed: R6.2, R8.1, U4.6 (-)
unnamed: R7.2, R9.1, U4.2 (-)
unnamed: R15.2, R16.1, U4.9 (-)
unnamed: R16.2, U4.8
unnamed: R17.1, U4.14
unnamed: R17.2, R18.1, U4.13 (-)
R5V: U4.3 (+), U4.5 (+)
R12V: C4.1, C5.1, U4.4 (V+)
