fcpage/EngPrg3/Schematics/AutoSketch/interface.kicad_sch

## KiCad design Schematics/AutoSketch/interface.kicad_sch (2025-11-06, an earlier design)

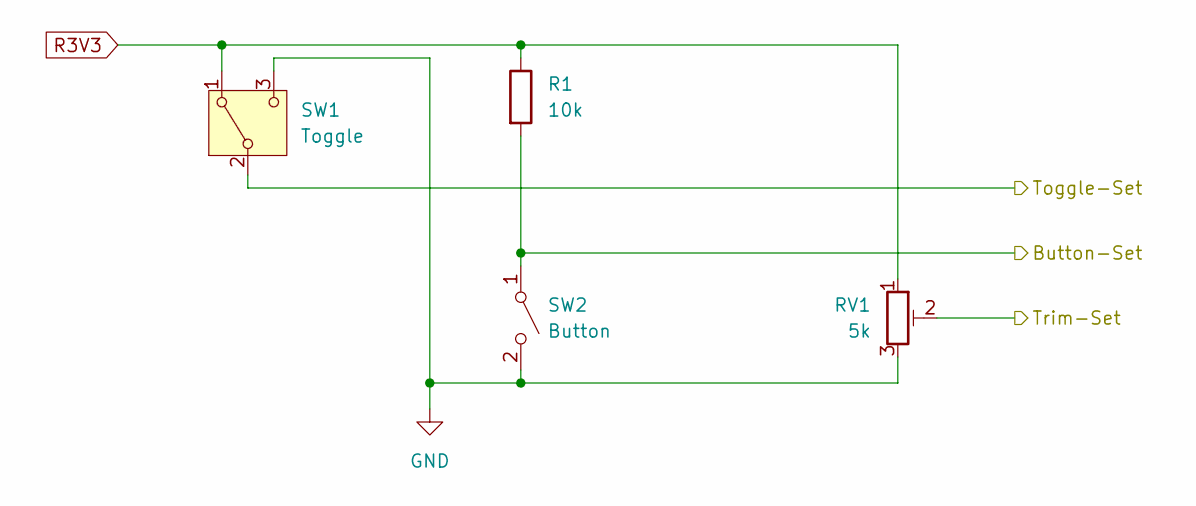
[picture p54: schematic interface.kicad_sch]

Parts:
R1: 10k
RV1: 5k
SW1: Toggle
SW2: Button

Connections:
Button-Set: R1.2, SW2.1 (A)
GND: RV1.3, SW1.3 (C), SW2.2 (B)
R3V3: R1.1, RV1.1, SW1.1 (A)
Toggle-Set: SW1.2 (B)
Trim-Set: RV1.2
