fcpage/EngPrg3/Schematics/AutoSketch/mcu.kicad_sch

## KiCad design Schematics/AutoSketch/mcu.kicad_sch (2025-11-06, an earlier design)

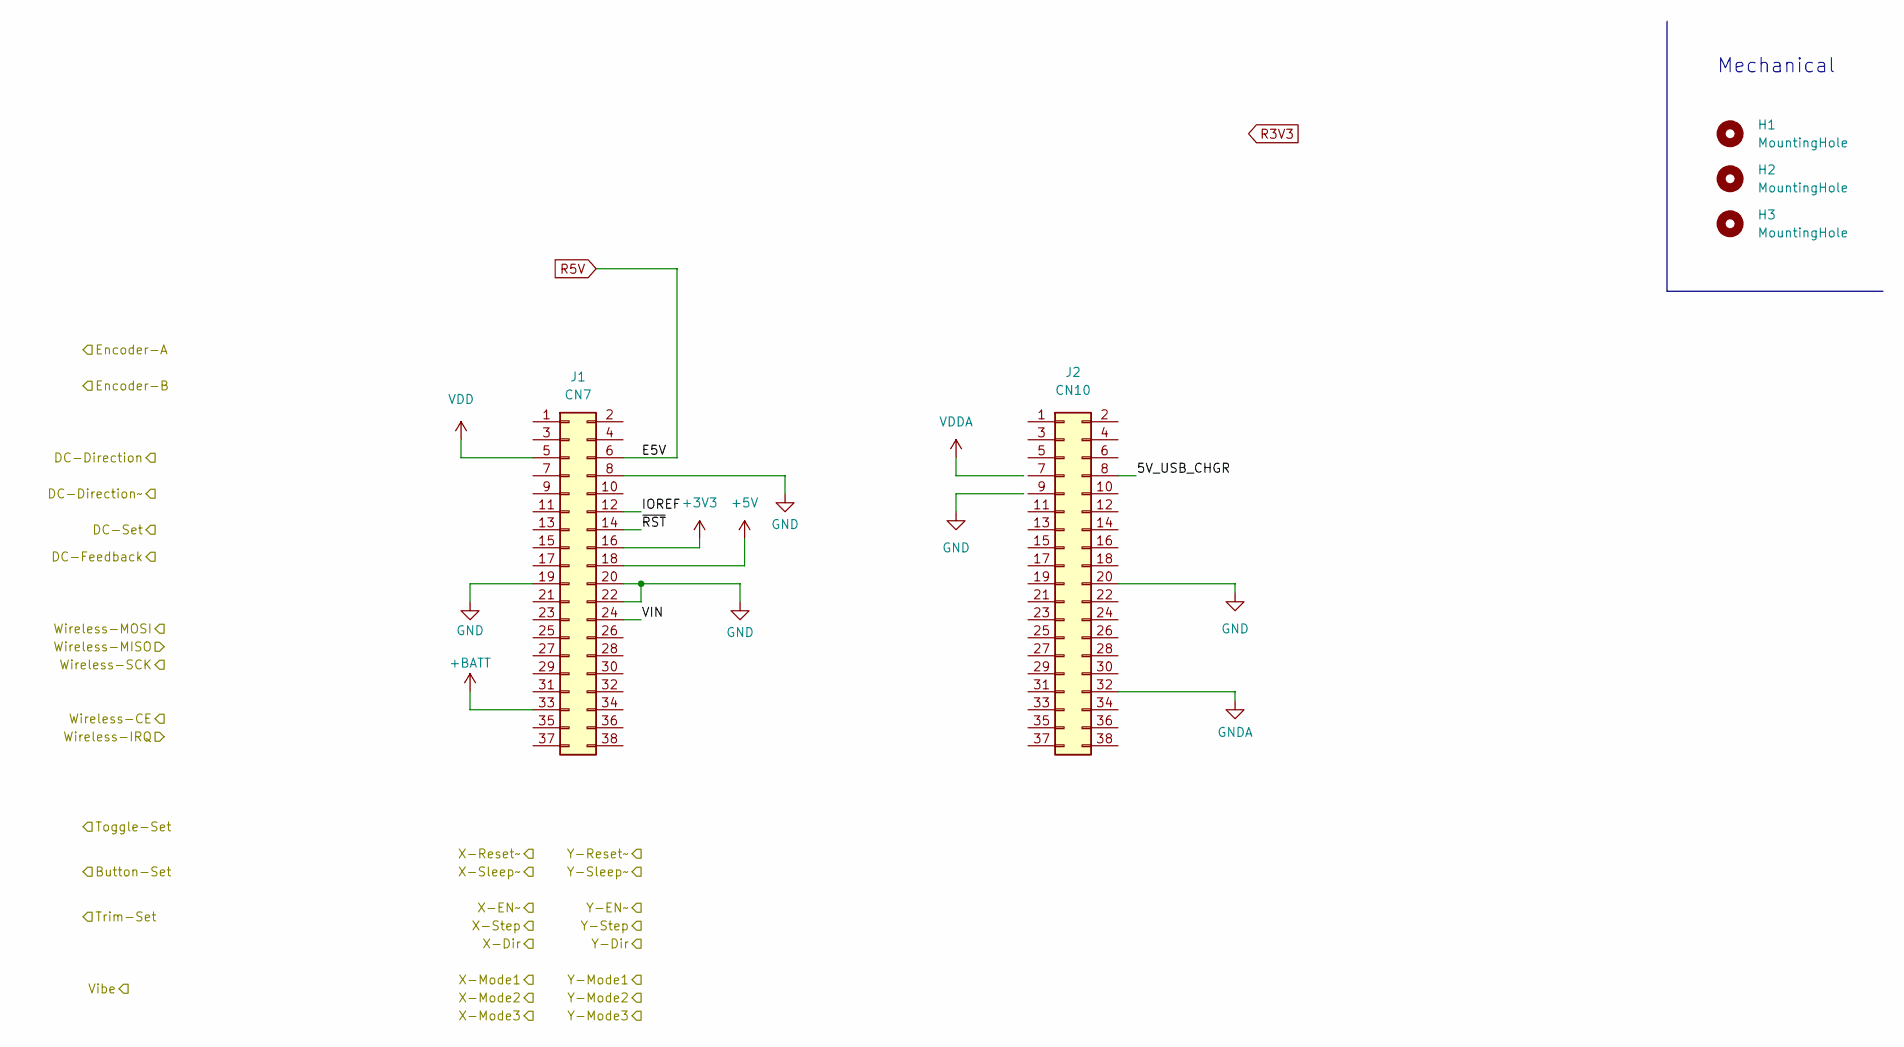
[picture p55: schematic mcu.kicad_sch]

Parts:
H1, H2, H3: MountingHole; MountingHole_3.2mm_M3
J1: CN7; PinSocket_2x19_P2.54mm_Vertical
J2: CN10; PinSocket_2x19_P2.54mm_Vertical

Connections:
5V_USB_CHGR: J2.8
+3V3: J1.16
+5V: J1.18
+BATT: J1.33
GND: J1.8, J1.19, J1.20, J1.22, J2.20
GNDA: J2.32
IOREF: J1.12
R5V: J1.6
VDD: J1.5
VIN: J1.24
~RST: J1.14

Notes on the sheet:
Mechanical
