fcpage/EngPrg3/Schematics/AutoSketch/pid.kicad_sch

## KiCad design Schematics/AutoSketch/pid.kicad_sch (2025-11-06, an earlier design)

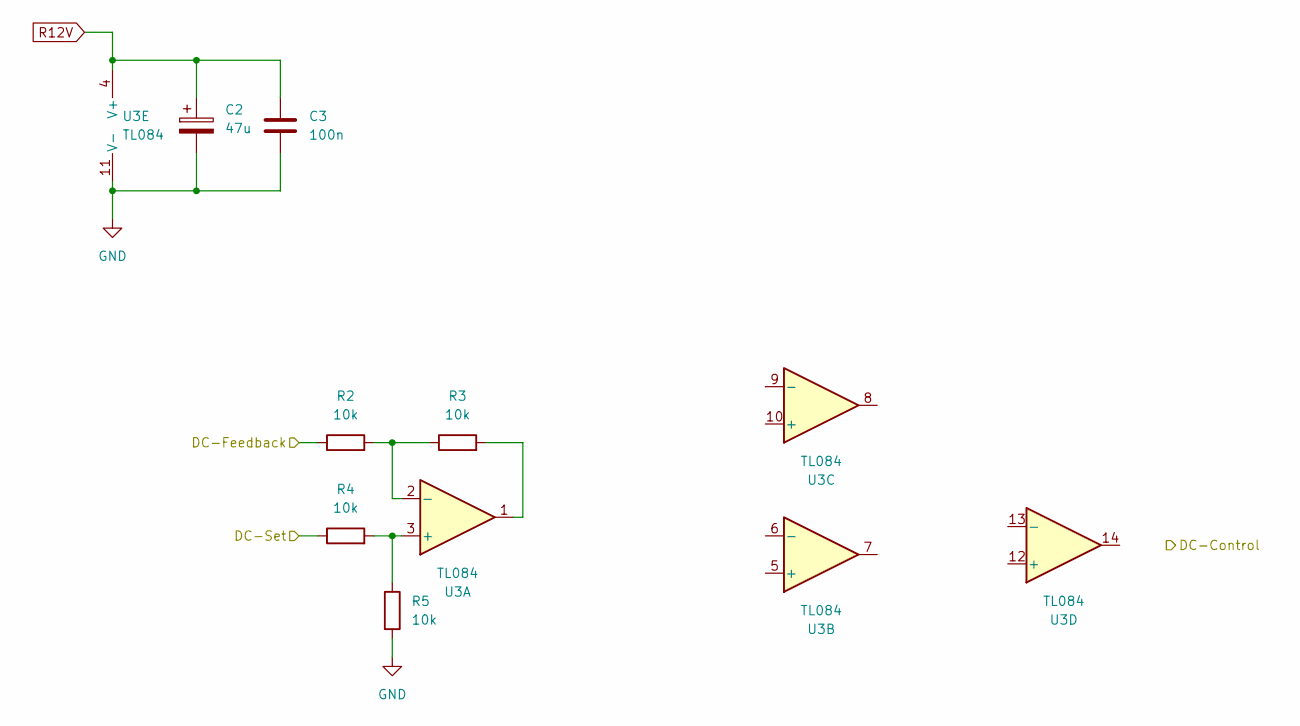
[picture p56: schematic pid.kicad_sch]

Parts:
C2: 47u
C3: 100n
R2, R3, R4, R5: 10k
U3: TL084

Connections:
DC-Feedback: R2.1
DC-Set: R4.1
GND: C2.2, C3.2, R5.2, U3.11 (V-)
unnamed: R2.2, R3.1, U3.2 (-)
unnamed: R3.2, U3.1
unnamed: R4.2, R5.1, U3.3 (+)
R12V: C2.1, C3.1, U3.4 (V+)
