fcpage/EngPrg3/Schematics/AutoSketch/power.kicad_sch

## KiCad design Schematics/AutoSketch/power.kicad_sch (2025-11-06, an earlier design)

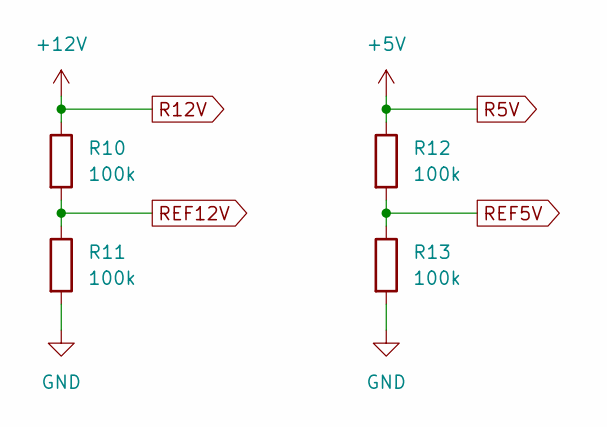
[picture p57: schematic power.kicad_sch]

Parts:
R10, R11, R12, R13: 100k

Connections:
+5V: R12.1
+12V: R10.1
GND: R11.2, R13.2
REF5V: R12.2, R13.1
REF12V: R10.2, R11.1
