fcpage/EngPrg3/Schematics/AutoSketch/sm.kicad_sch

## KiCad design Schematics/AutoSketch/sm.kicad_sch (2025-11-06, an earlier design)

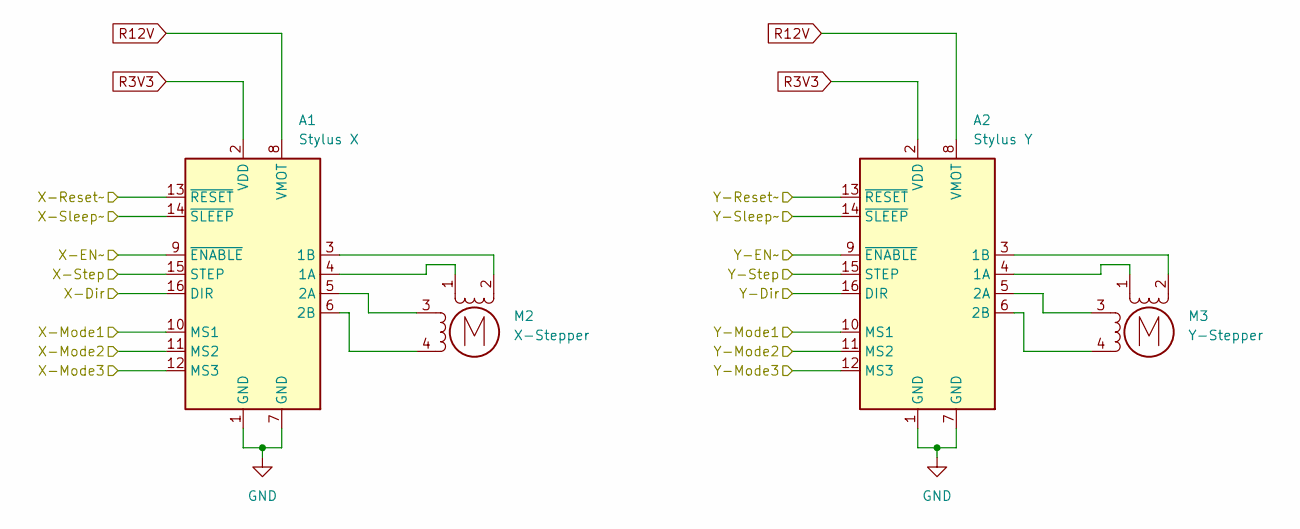
[picture p58: schematic sm.kicad_sch]

Parts:
A1: Stylus X; Pololu_Breakout-16_15.2x20.3mm
A2: Stylus Y; Pololu_Breakout-16_15.2x20.3mm
M2: X-Stepper
M3: Y-Stepper

Connections:
GND: A1.1 (GND), A1.7 (GND), A2.1 (GND), A2.7 (GND)
unnamed: A1.3 (1B), M2.2 (-)
unnamed: A1.4 (1A), M2.1
unnamed: A1.5 (2A), M2.3
unnamed: A1.6 (2B), M2.4
unnamed: A2.3 (1B), M3.2 (-)
unnamed: A2.4 (1A), M3.1
unnamed: A2.5 (2A), M3.3
unnamed: A2.6 (2B), M3.4
R3V3: A1.2 (VDD), A2.2 (VDD)
R12V: A1.8 (VMOT), A2.8 (VMOT)
X-Dir: A1.16 (DIR)
X-EN~: A1.9 (~ENABLE)
X-Mode1: A1.10 (MS1)
X-Mode2: A1.11 (MS2)
X-Mode3: A1.12 (MS3)
X-Reset~: A1.13 (~RESET)
X-Sleep~: A1.14 (~SLEEP)
X-Step: A1.15 (STEP)
Y-Dir: A2.16 (DIR)
Y-EN~: A2.9 (~ENABLE)
Y-Mode1: A2.10 (MS1)
Y-Mode2: A2.11 (MS2)
Y-Mode3: A2.12 (MS3)
Y-Reset~: A2.13 (~RESET)
Y-Sleep~: A2.14 (~SLEEP)
Y-Step: A2.15 (STEP)
