fcpage/EngPrg3/Schematics/AutoSketch/vibe.kicad_sch

## KiCad design Schematics/AutoSketch/vibe.kicad_sch (2025-11-06, an earlier design)

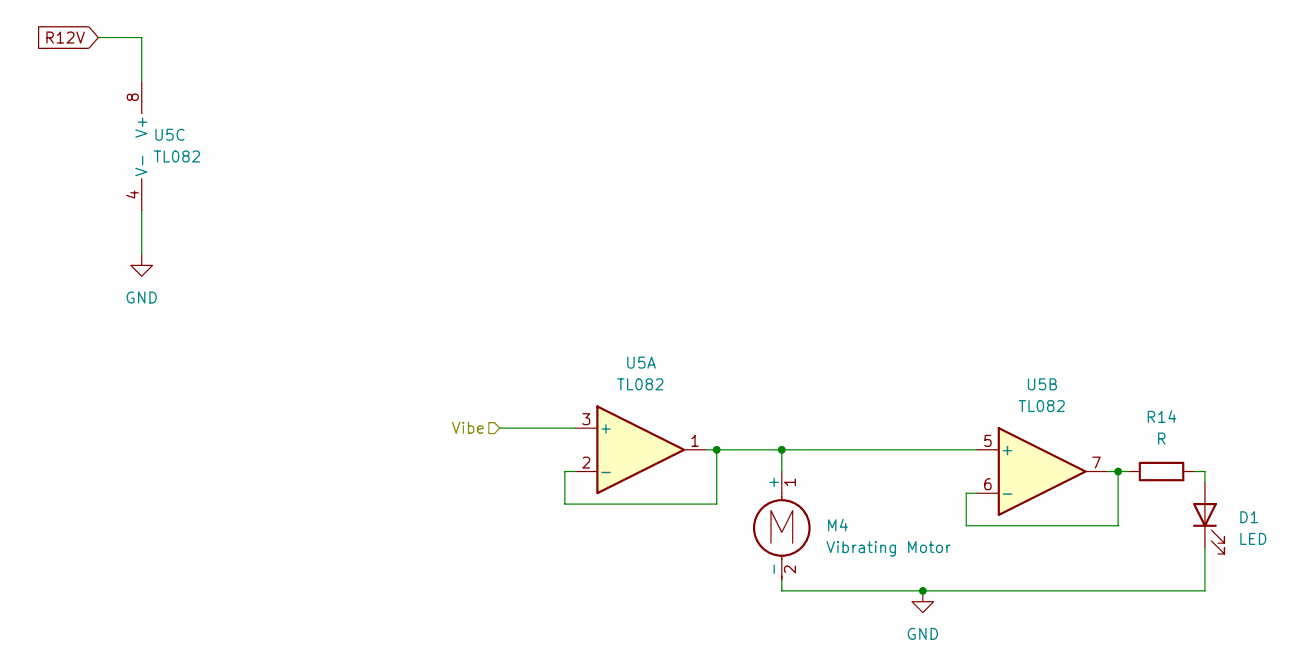
[picture p59: schematic vibe.kicad_sch]

Parts:
D1: LED
M4: Vibrating Motor
R14: R
U5: TL082

Connections:
GND: D1.1 (K), M4.2 (-), U5.4 (V-)
unnamed: D1.2 (A), R14.2
unnamed: M4.1 (+), U5.1, U5.2 (-), U5.5 (+)
unnamed: R14.1, U5.6 (-), U5.7
R12V: U5.8 (V+)
Vibe: U5.3 (+)
