fcpage/EngPrg3/Code/STMcode/pwm.h

#ifndef PWM_H
#define	PWM_H



#define PWM_RESOLUTION 32
//TIM2 - USE CCR and OCR to generate PWM from encoder pulsetrains
//Use Second timer to measure periods between pulses to generate velocity and accelleration data

#endif
