fcpage/EngPrg3/(commit log)

2025-11-06 EngPrj3
    Dump
    [AutoSketch.kicad_pcb, AutoSketch.kicad_sch, Master Sheet.xlsx, dcm.kicad_sch, encoder.kicad_sch, interface.kicad_sch, limit.kicad_sch, mcu.kicad_sch]
2025-11-06 EngPrj3
    Schematics
    [AutoSketch.kicad_sch, dcm.kicad_sch, encoder.kicad_sch, interface.kicad_sch, limit.kicad_sch, mcu.kicad_sch, pid.kicad_sch, power.kicad_sch]
2025-11-19 Project 3
    Scope Shots
    `
    [DRIVEN_STE.csv, DRIVER_STE.csv, Master Sheet.xlsx, RAW_STEP.csv, WC_STEP_RA.csv, step.csv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]
2025-12-02 prj3
    code dump
    [Master Sheet.xlsx]
